ythuang96/FoamCutter/README.md

# FoamCutter

Download and unzip 'User Package.zip' for manual and all required code and AutoCAD templates.
