ythuang96/FoamCutter/SWITCH.docx

EXIT SWITCH | PAUSE SWITCH | WIRE CONTROL
| Pause | Wire always heated
Long hold to exit program and turn off Pi
| Running | Wire controlled by program
