ythuang96/FoamCutter/Code/C/RPI GPIO.png

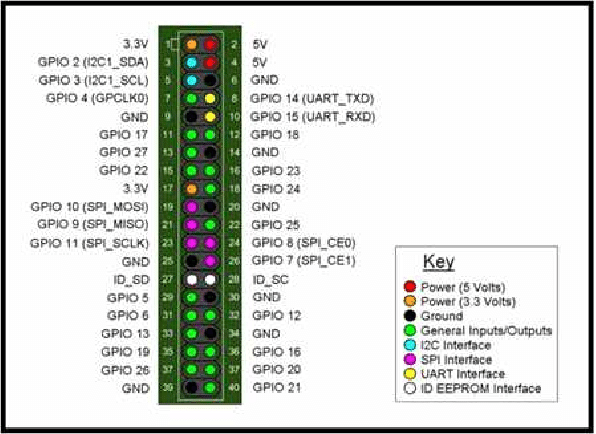
Code/C/RPI GPIO.png
