ythuang96/FoamCutter/Foamcutter V2.PNG

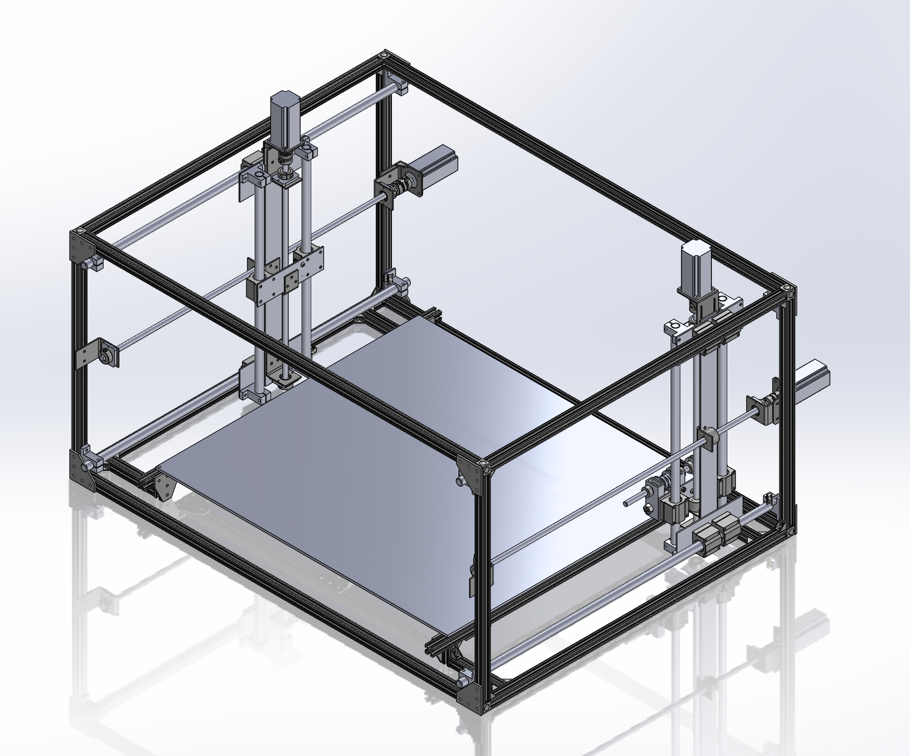
Foamcutter V2.PNG
