ythuang96/FoamCutter/Parts/Purchase_History.pdf

Category | Name | Spec | Unit Price | Amount for Final Desgin | | Amount Order1 | $1,235.68 | | Amount Order2 | $1,256.92 | | Amount Order3 | $148.63 | | Order4 Amount | $53.70
T-Slot | Rail | 1'' | 4ft | $12.31 | 4 | | 4 | $49.24 | | ---- | ---- | | ---- | ---- | | ---- | ----
| | | 3ft | $10.57 | 10 | | 9 | $95.13 | | 1 | $10.57 | | ---- | ---- | | ---- | ----
| | | 2ft | $7.79 | 5 | | 5 | $38.95 | | 1 | $7.79 | | ---- | ---- | | ---- | ----
| | | 1ft | $5.84 | 2 | | ---- | ---- | | ---- | ---- | | 2 | $11.68 | | ---- | ----
| Corner Brace | | | $4.96 | 38 | | 32 | $158.72 | | 6 | $29.76 | | ---- | ---- | | ---- | ----
| Corner Surface Bracket | | | $7.62 | 8 | | 8 | $60.96 | | 4 | $30.48 | | 8 | $60.96 | | ---- | ----
| Tee Surface Bracket | | | $7.95 | 10 | | 10 | $79.50 | | ---- | ---- | | ---- | ---- | | 2 | $15.90
| 3 Way Outside Corner | | | $9.86 | 8 | | 8 | $78.88 | | ---- | ---- | | ---- | ---- | | ---- | ----
| Fasten Plate | Single | | $2.30 | 10 | | 10 | $23.00 | | ---- | ---- | | ---- | ---- | | ---- | ----
| Fasten Plate | Dual | 1'' screw distance | $4.29 | 10 | | 10 | $42.90 | | ---- | ---- | | ---- | ---- | | ---- | ----
| Dust Cover | | | $4.15 | 3 | | 3 | $12.45 | | ---- | ---- | | ---- | ---- | | ---- | ----
Aluminum | L Bracket | 75 * 60 * 50 mm | $13.60 | 8 | 8 | $108.80 | ---- | ---- | ---- | ---- | ---- | ----
| L Bracket | 50 * 50 * 40 mm | $8.39 | 4 | 4 | $33.56 | ---- | ---- | ---- | ---- | ---- | ----
| Al Sheet | 2 * 24 * 1/8'' | $10.46 | 2 | 2 | $20.92 | ---- | ---- | ---- | ---- | ---- | ----
| Al Sheet | 8 * 8 * 1/8'' | $13.07 | 3 | 3 | $39.21 | ---- | ---- | ---- | ---- | ---- | ----
| Al Rod | 1 1/4'' OD 1'' length | $2.96 | 1 | ---- | ---- | ---- | ---- | 1 | $2.96 | ---- | ----
Electronics | Manual Switch | Toggle - Monentary | | $9.14 | 1 | 1 | $9.14 | ---- | ---- | ---- | ---- | ---- | ----
| | Toggle - Maintained | | $4.34 | 2 | 2 | $8.68 | ---- | ---- | ---- | ---- | ---- | ----
| Limit Switch | | | $7.17 | 4 | 4 | $28.68 | ---- | ---- | ---- | ---- | ---- | ----
| Standoff | | | $1.66 | 10 | 10 | $16.60 | ---- | ---- | ---- | ---- | ---- | ----
| Flat cable Signal | 26 awg | 4 cable | $2.08 | 10 | 10 | $20.80 | ---- | ---- | ---- | ---- | ---- | ----
| Flat cable Power | 18 awg | 4 cable | $3.78 | 10 | 10 | $37.80 | ---- | ---- | ---- | ---- | 10 | $37.80
Panel | Ruler | L to R | | $2.31 | 5 | 5 | $11.55 | ---- | ---- | ---- | ---- | ---- | ----
| | R to L | | $2.31 | 5 | 5 | $11.55 | ---- | ---- | ---- | ---- | ---- | ----
| Perforated Sheet | PVC 1/4'' thick | Hole D 0.25'' | $92.78 | 1 | 1 | $92.78 | ---- | ---- | ---- | ---- | ---- | ----
Wire Retractor | Constant-Force Spring | 10.60 lbs | Width 1'' | $10.83 | 1 | 1 | $10.83 | ---- | ---- | ---- | ---- | ---- | ----
| Sleeve Bearing | | Length 1/2'' | $0.67 | 1 | 1 | $0.67 | ---- | ---- | ---- | ---- | ---- | ----
| Sleeve Bearing | | Length 1 1/2'' | $4.71 | 1 | 1 | $4.71 | ---- | ---- | ---- | ---- | ---- | ----
| Sleeve Bearing | | Length 3/8'' | $1.50 | 0 | 2 | $3.00 | ---- | ---- | ---- | ---- | ---- | ----
| Flanged Sleeve Bearing | | Length 1'' | $2.28 | 2 | 2 | $4.56 | ---- | ---- | ---- | ---- | ---- | ----
| One-way Bearing | | Length 1/2'' | $11.17 | 1 | 1 | $11.17 | ---- | ---- | ---- | ---- | ---- | ----
| Shaft | | Length 9'' | $19.40 | 1 | 1 | $19.40 | ---- | ---- | ---- | ---- | ---- | ----
| Shaft Collar | | | $2.77 | 4 | 4 | $11.08 | ---- | ---- | ---- | ---- | ---- | ----
| Rectangular Tube | | Length 12'' | $9.12 | 1 | 1 | $9.12 | ---- | ---- | ---- | ---- | ---- | ----

Category | Name | Spec | Unit Price | Amount for Final Desgin | | Amount Order1 | $1,235.68 | | Amount Order2 | $1,256.92 | | Amount Order3 | $148.63 | | Order4 Amount | $53.70
Screw | Button Head Screw | 2-56 1/4'' | | $5.97 | 1 | | 1 | $5.97 | | ---- | ---- | | ---- | ---- | | ---- | ----
| | 4-40 0.5'' | | $3.38 | 1 | | 1 | $3.38 | | ---- | ---- | | ---- | ---- | | ---- | ----
| | 4-40 1 3/8'' | | $5.19 | 1 | | 1 | $5.19 | | ---- | ---- | | ---- | ---- | | ---- | ----
| | 1/4-20 0.5'' | | $8.35 | 1 | | 1 | $8.35 | | ---- | ---- | | ---- | ---- | | ---- | ----
| | 1/4-20 1'' | | $6.72 | 1 | | 1 | $6.72 | | ---- | ---- | | ---- | ---- | | ---- | ----
| Socket Head Screw | 1/2-13 3.5'' | | $5.05 | 1 | | 1 | $5.05 | | ---- | ---- | | ---- | ---- | | ---- | ----
| | M6 12mm | | $7.44 | 1 | | 1 | $7.44 | | ---- | ---- | | ---- | ---- | | ---- | ----
| | M6 20mm | | $4.44 | 1 | | 1 | $4.44 | | ---- | ---- | | ---- | ---- | | ---- | ----
| | M6 30mm | | $9.41 | 0 | | 1 | $9.41 | | ---- | ---- | | ---- | ---- | | ---- | ----
| Thumb Screw | 1/4-20 1/2'' | | $2.65 | 24 | | ---- | ---- | | ---- | ---- | | 24 | $63.60 | | ---- | ----
Nut | 4-40 Nut | | | $2.91 | 1 | | 1 | $2.91 | | ---- | ---- | | ---- | ---- | | ---- | ----
| 1/4-20 Nut | | | $7.24 | 1 | | 1 | $7.24 | | ---- | ---- | | ---- | ---- | | ---- | ----
| 1/2-13 Nut | | | $6.51 | 1 | | 1 | $6.51 | | ---- | ---- | | ---- | ---- | | ---- | ----
| M6 Nut | | | $8.73 | 1 | | 1 | $8.73 | | ---- | ---- | | ---- | ---- | | ---- | ----
Shaft | Shaft | 20mm | 1000mm | $95.82 | 4 | ---- | ---- | 2 | $191.64 | ---- | ---- | ---- | ----
| | 20mm | 600mm | $57.48 | 4 | ---- | ---- | 0 | $0.00 | ---- | ---- | ---- | ----
| Shaft Support | | | $25.19 | 16 | ---- | ---- | 8 | $201.52 | ---- | ---- | ---- | ----
Transmission | Linear Bearings | | | $68.20 | 12 | ---- | ---- | 4 | $272.80 | ---- | ---- | ---- | ----
| Shaft Coupler | 10mm to 1/2 inch | | $68.64 | 4 | ---- | ---- | 0 | $0.00 | ---- | ---- | ---- | ----
| Lead screw | 1/2''-10 | 3 ft | $36.59 | 4 | ---- | ---- | 4 | $146.36 | ---- | ---- | ---- | ----
| Nut | | OD 1.47'' | $36.81 | 4 | ---- | ---- | 4 | $147.24 | ---- | ---- | ---- | ----
| Collar | | OD 1.3125'' | $18.35 | 8 | ---- | ---- | 4 | $73.40 | ---- | ---- | ---- | ----
| Bearing | | OD 1.125'' | $9.08 | 0 | ---- | ---- | 8 | $72.64 | ---- | ---- | ---- | ----
| Shim | | | $11.59 | 1 | ---- | ---- | 1 | $11.59 | ---- | ---- | ---- | ----
Acrylic | 24'' * 48'' *1/4'' | $55.76 | 1 | ---- | ---- | 1 | $55.76 | ---- | ---- | ---- | ----
Acrylic | 6'' * 12'' * 1/8'' | $5.37 | 1 | ---- | ---- | 1 | $5.37 | ---- | ---- | ---- | ----
Delrin | 6'' * 6'' * 1/4'' | $9.43 | 1 | ---- | ---- | ---- | ---- | 1 | $9.43 | ---- | ----
