ythuang96/FoamCutter/Parts/ps_4__80714.1506972392.jpg

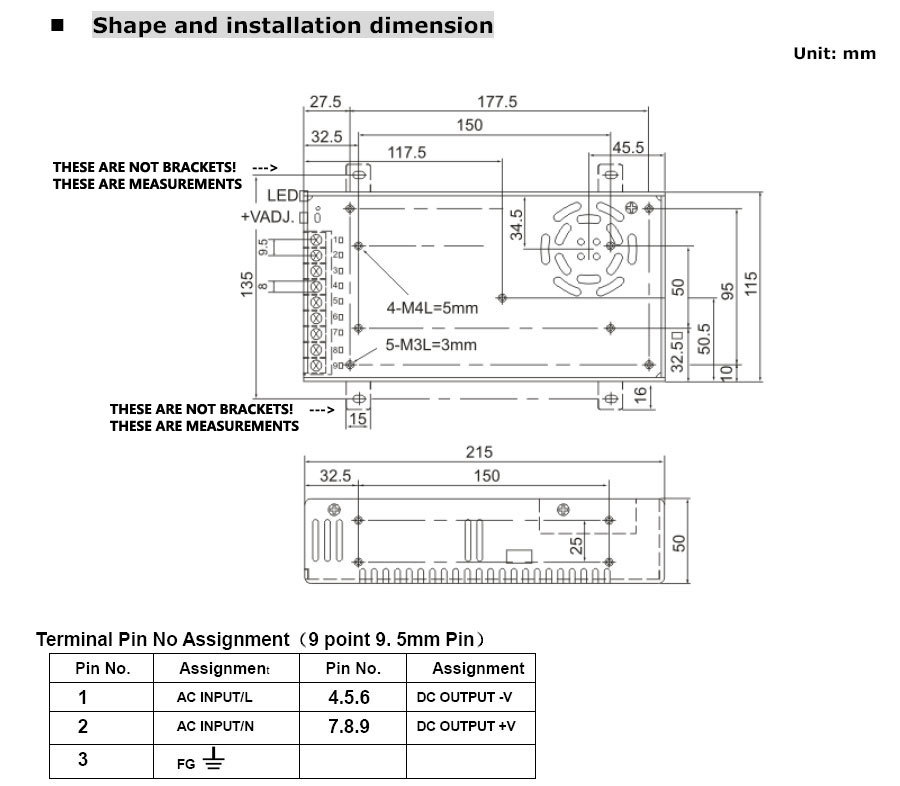
Parts/ps_4__80714.1506972392.jpg
