ythuang96/FoamCutter/Solidworks Files/Assembly/Frame/Electronics Box.SLDASM

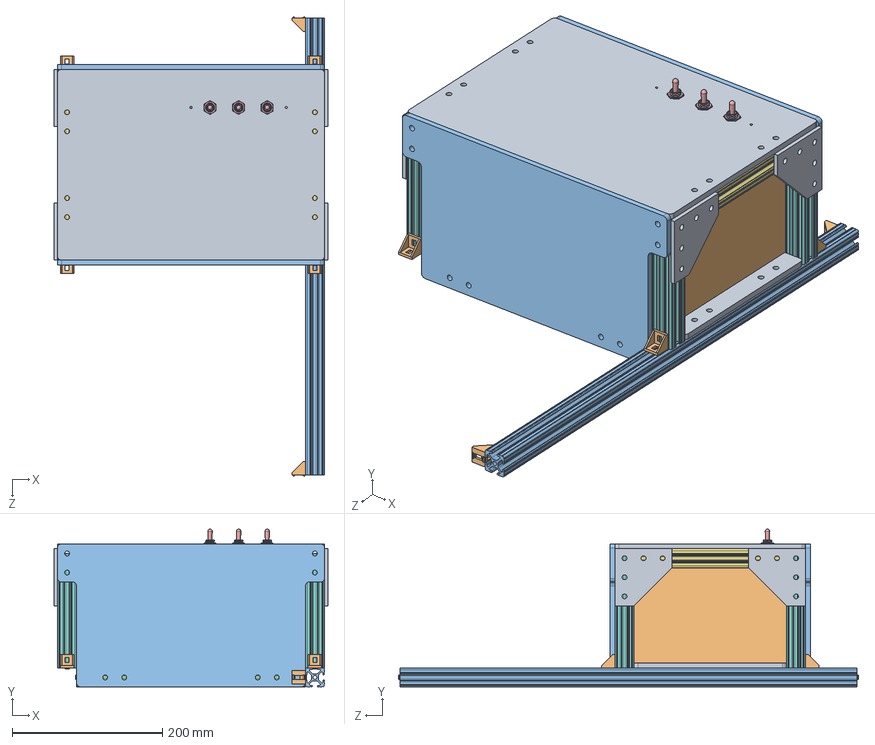
[picture p4: CAD file, 2018-08-23]
Solidworks Files/Assembly/Frame/Electronics Box.SLDASM
365.1 x 210.3 x 613.2 mm
Box Bottom x 2
Box Left x 2
Box Front x 2
Motor Drive x 4
PSU
pi
8 in x 2
6 in x 4
Corner Surface x 4
Corner Brace x 10
2 ft
1 ft x 2
Switch x 3
Switch Holder
