ythuang96/FoamCutter/Solidworks Files/Assembly/Horizontal Rail.SLDASM

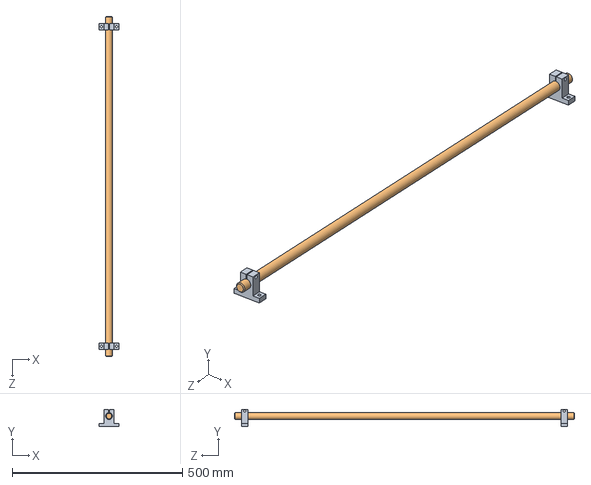
[picture p5: CAD file, 2018-08-23]
Solidworks Files/Assembly/Horizontal Rail.SLDASM
60.0 x 51.0 x 1000.0 mm
Shaft Clamp 20mm x 2
Shaft 1000mm
