ythuang96/FoamCutter/Solidworks Files/Assembly/Frame/Frame.SLDASM

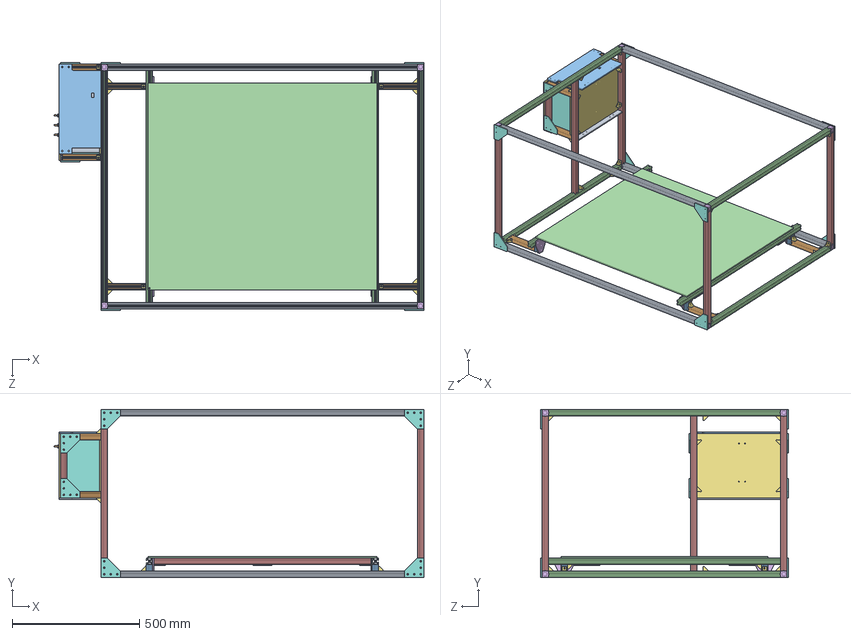
[picture p6: CAD file, 2018-08-23]
Solidworks Files/Assembly/Frame/Frame.SLDASM
1455.4 x 661.5 x 974.7 mm
3 ft x 6
2 ft x 6
Outside Corner x 8
Corner Brace x 42
Corner Surface x 12
4 ft x 4
6 in x 8
2 in x 4
PVC Panel
34in x 2
Surface T x 10
Box Bottom x 2
Box Left x 2
Box Front x 2
Motor Drive x 4
PSU
pi
8 in x 2
Switch x 3
Switch Holder
