ythuang96/FoamCutter/Solidworks Files/Assembly/Horizontal Motor.SLDASM

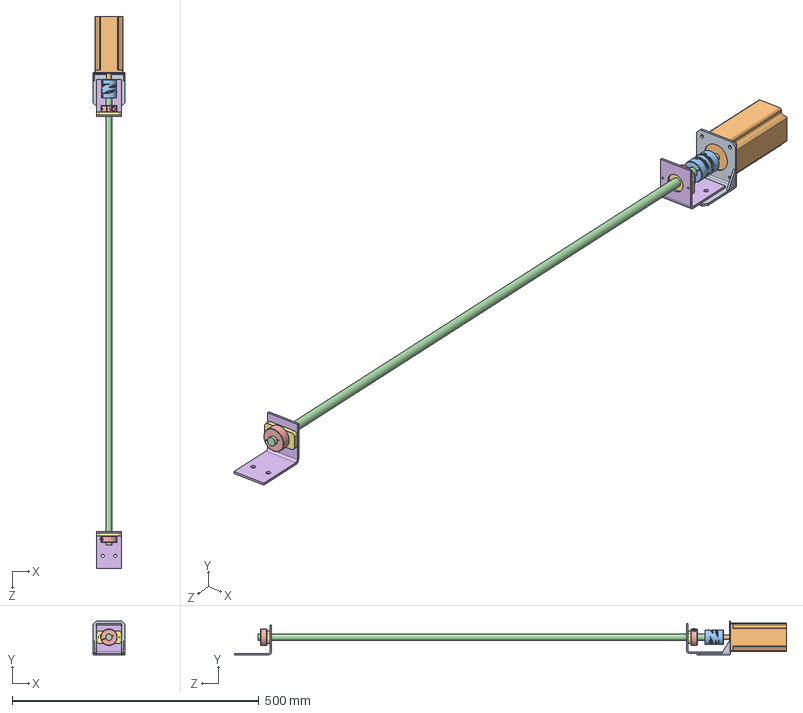
[picture p7: CAD file, 2018-08-23]
Solidworks Files/Assembly/Horizontal Motor.SLDASM
65.0 x 68.0 x 1118.5 mm
Motor Mount
Nema 23 Stepper Motor
Shaft Coupler
Lead Screw 3ft
Collar x 2
L Bracket x 2
Acrylic Bearing Mount x 2
