ythuang96/FoamCutter/Solidworks Files/Wire Retraction/Spring Pulley 2.SLDASM

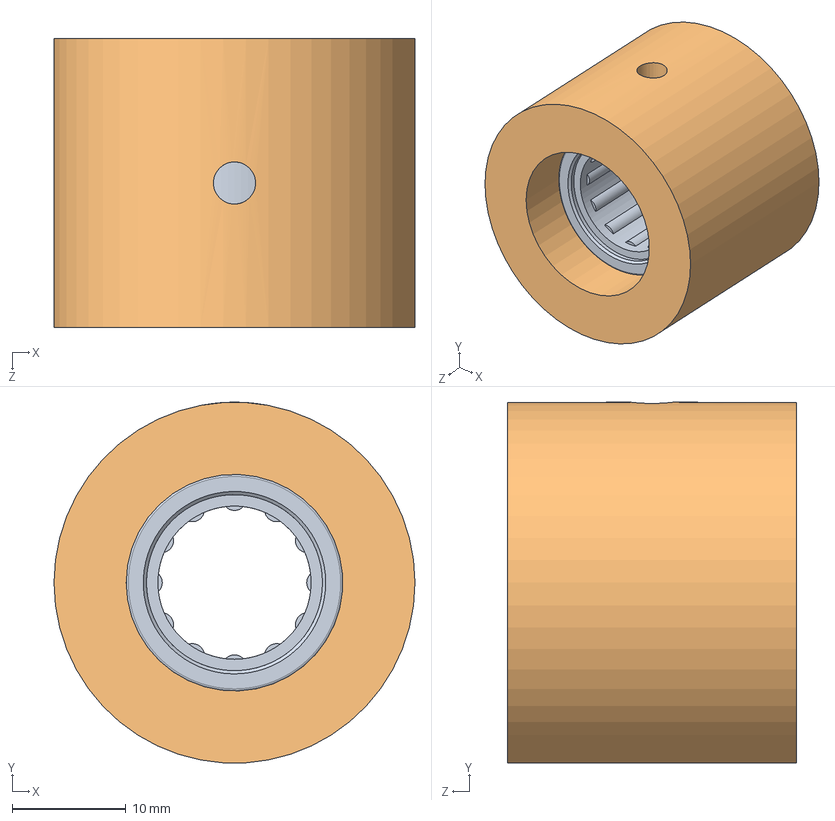
[picture p8: CAD file, 2018-08-23]
Solidworks Files/Wire Retraction/Spring Pulley 2.SLDASM
31.8 x 31.7 x 25.4 mm
One-Way Bearing
Al Pulley
