ythuang96/FoamCutter/Solidworks Files/Assembly/Frame/Box Side Frame.SLDASM

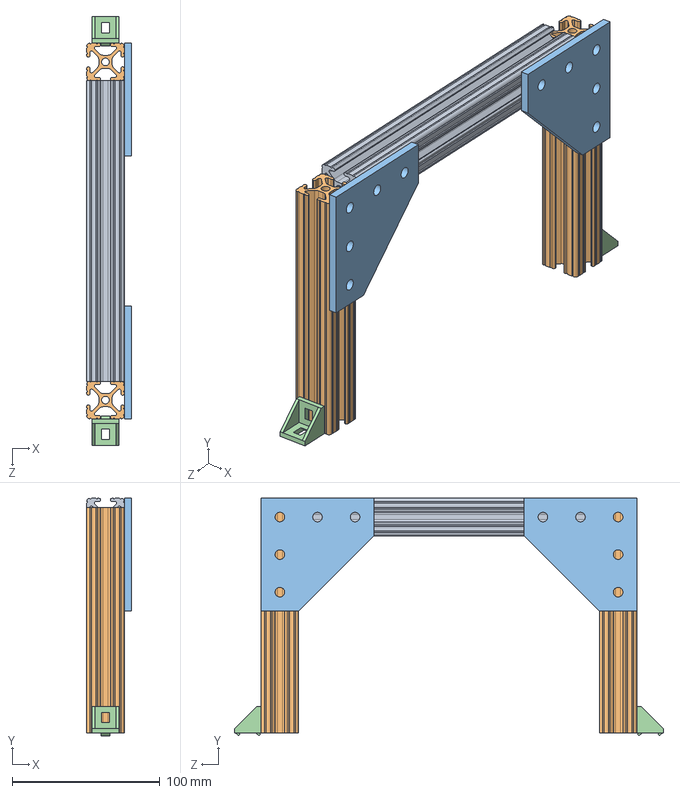
[picture p9: CAD file, 2018-08-23]
Solidworks Files/Assembly/Frame/Box Side Frame.SLDASM
30.2 x 160.6 x 290.0 mm
8 in
6 in x 2
Corner Surface x 2
Corner Brace x 2
