ythuang96/FoamCutter/Solidworks Files/Assembly/Vertical Motor.SLDASM

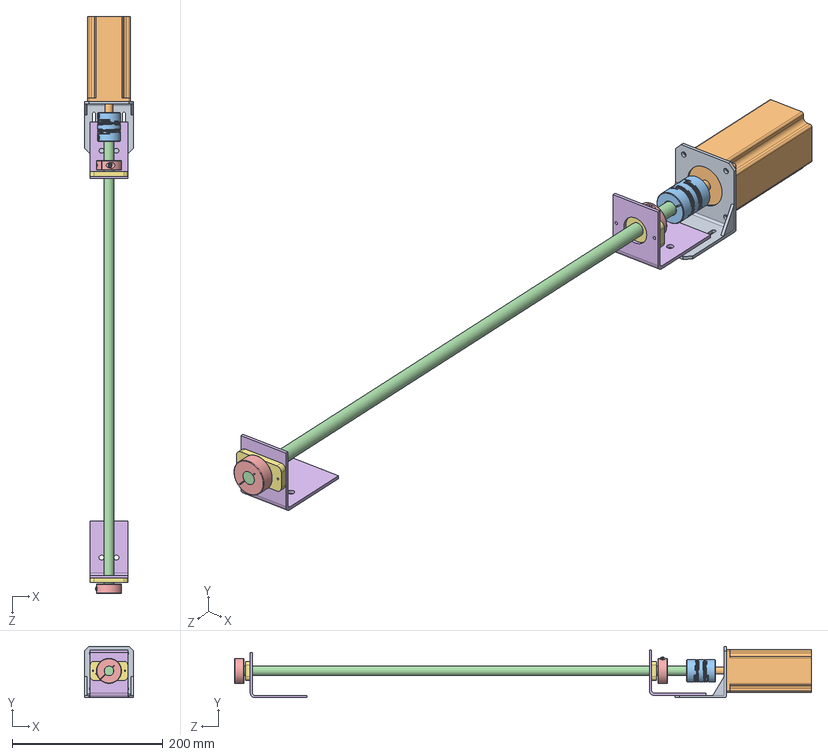
[picture p10: CAD file, 2018-08-23]
Solidworks Files/Assembly/Vertical Motor.SLDASM
65.0 x 68.0 x 765.8 mm
Motor Mount
Nema 23 Stepper Motor
Shaft Coupler
Lead Screw 2.5ft
Collar x 2
L Bracket x 2
Acrylic Bearing Mount x 2
