ythuang96/FoamCutter/Solidworks Files/Assembly/Frame/Side Frame.SLDASM

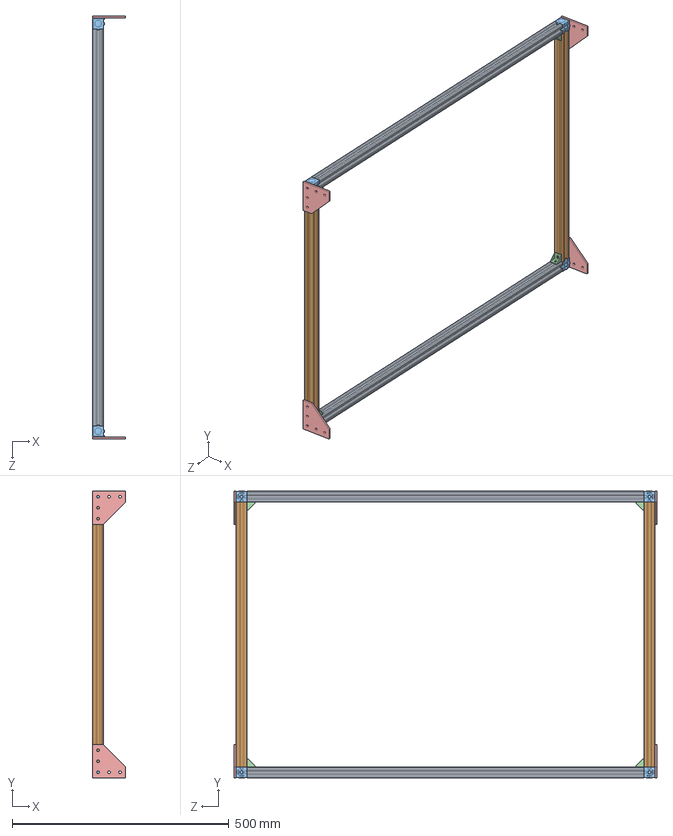
[picture p11: CAD file, 2018-08-23]
Solidworks Files/Assembly/Frame/Side Frame.SLDASM
76.7 x 661.5 x 974.7 mm
3 ft x 2
2 ft x 2
Outside Corner x 4
Corner Brace x 4
Corner Surface x 4
