ythuang96/FoamCutter/Solidworks Files/Assembly/Limit Swtich Assembly 2.SLDASM

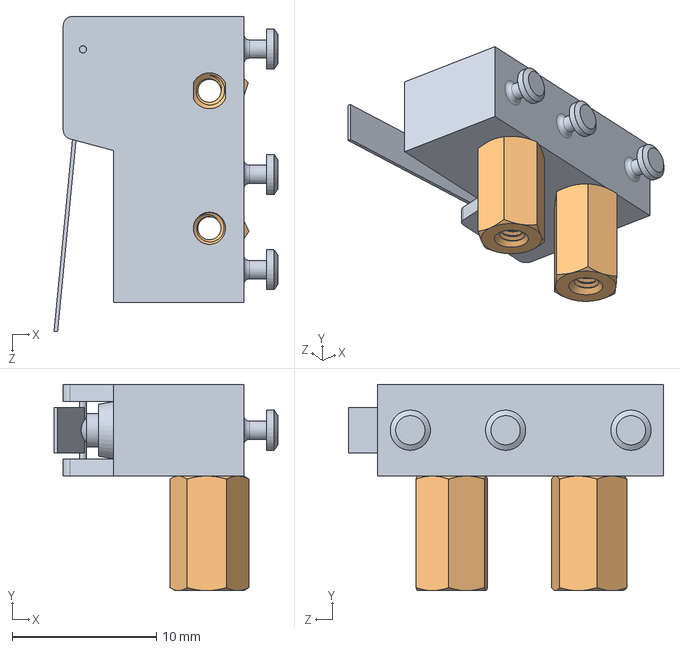
[picture p12: CAD file, 2018-08-23]
Solidworks Files/Assembly/Limit Swtich Assembly 2.SLDASM
15.5 x 14.3 x 21.8 mm
Limit Switch
Standoff x 2
