ythuang96/FoamCutter/Solidworks Files/Assembly/Vertical Left.SLDASM

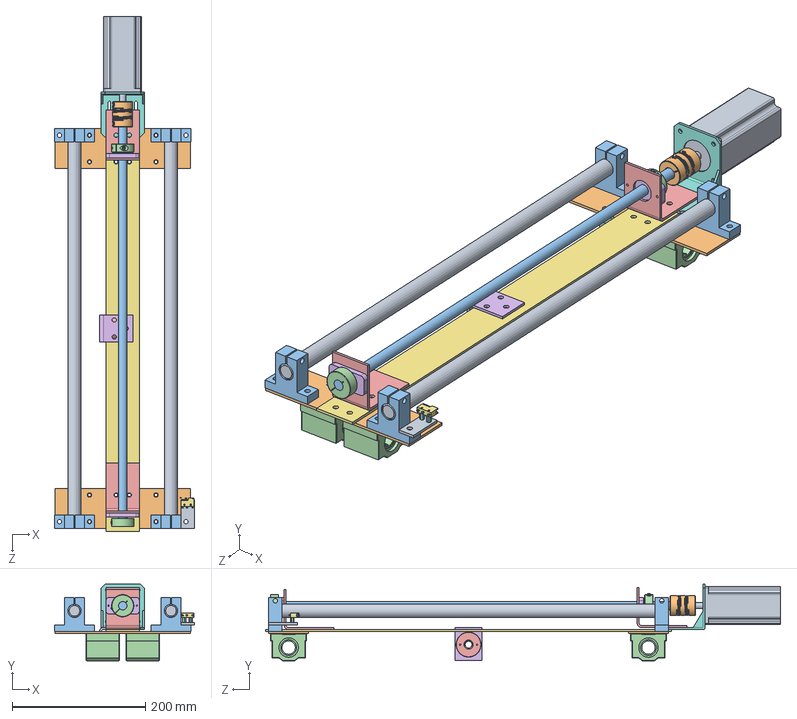
[picture p13: CAD file, 2018-08-23]
Solidworks Files/Assembly/Vertical Left.SLDASM
210.1 x 115.3 x 773.0 mm
Shaft 600mm x 2
Al sheet 1 x 2
Shaft Clamp 20mm x 4
20mm Linear Bearing x 4
Nut
L Bracket -- Nut Horizontal
Al sheet 2
Motor Mount
Nema 23 Stepper Motor
Shaft Coupler
Lead Screw 2.5ft
Collar x 2
L Bracket x 2
Acrylic Bearing Mount x 2
Limit Switch
Standoff x 2
Al sheet 4-2
