ythuang96/FoamCutter/Solidworks Files/Wire Retraction/Wire Pulley.SLDASM

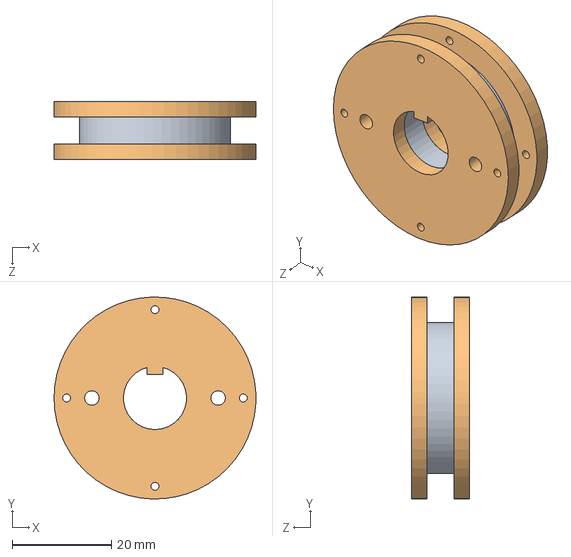
[picture p14: CAD file, 2018-08-23]
Solidworks Files/Wire Retraction/Wire Pulley.SLDASM
40.6 x 40.6 x 11.7 mm
Wire Pully Inside
Flange x 2
