ythuang96/FoamCutter/Solidworks Files/Assembly/Wire Holder Left.SLDASM

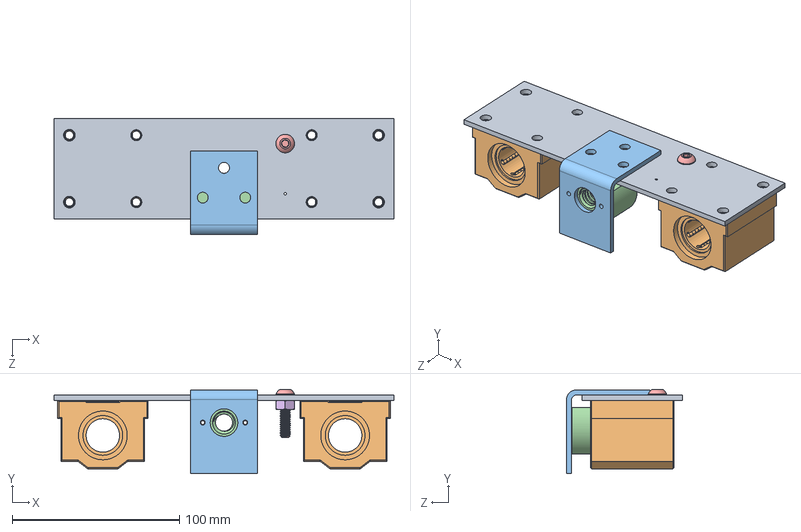
[picture p15: CAD file, 2018-08-23]
Solidworks Files/Assembly/Wire Holder Left.SLDASM
203.2 x 50.4 x 69.4 mm
Al sheet 3-1
20mm Linear Bearing x 2
L Bracket -- Nut Vertical
Nut
0.25 Nut
