ythuang96/FoamCutter/Solidworks Files/Assembly/Vertical Slider.SLDASM

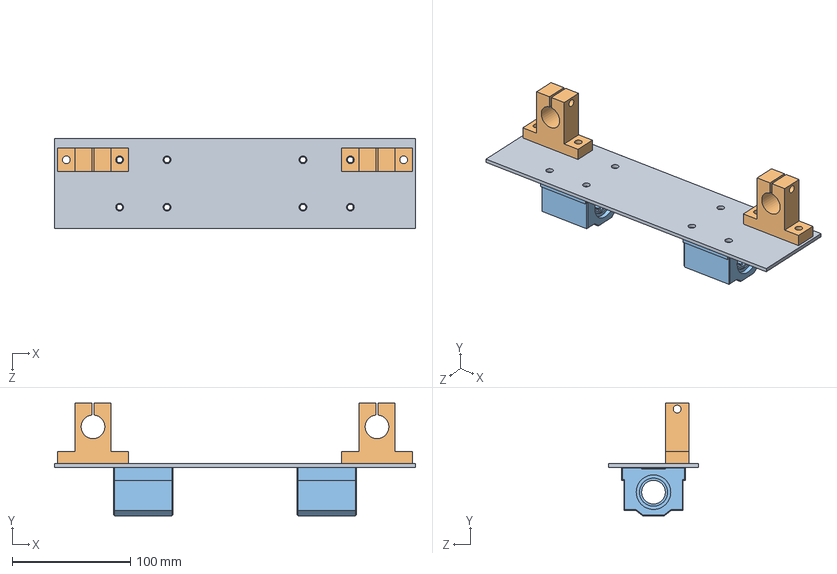
[picture p16: CAD file, 2018-08-23]
Solidworks Files/Assembly/Vertical Slider.SLDASM
304.8 x 95.2 x 76.2 mm
Al sheet 1
Shaft Clamp 20mm x 2
20mm Linear Bearing x 2
