ythuang96/FoamCutter/Solidworks Files/Wire Retraction/Spring Assembly.SLDASM

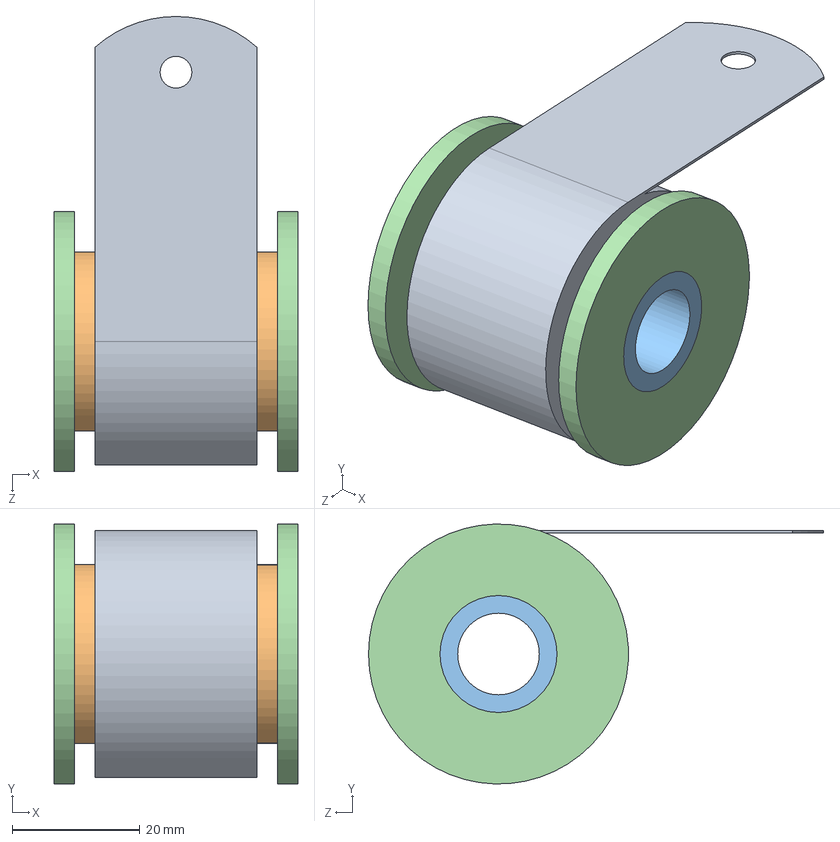
[picture p17: CAD file, 2018-08-23]
Solidworks Files/Wire Retraction/Spring Assembly.SLDASM
38.1 x 40.6 x 71.1 mm
Constant Force Spring
Spring Pully Inside x 5
Sleeve Bearing 1.5
Flange x 2
