ythuang96/FoamCutter/Solidworks Files/Wire Retraction/Retractor Assembly.SLDASM

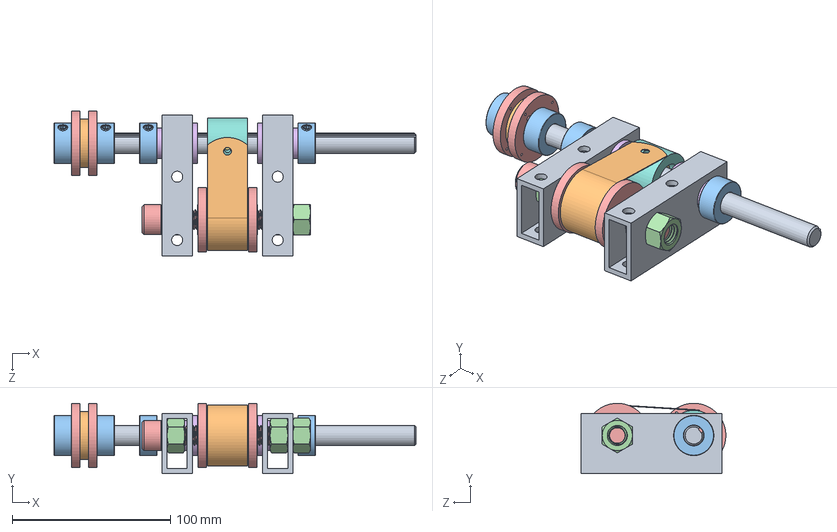
[picture p18: CAD file, 2018-08-23]
Solidworks Files/Wire Retraction/Retractor Assembly.SLDASM
228.6 x 44.4 x 91.4 mm
Rectangle Tube x 2
Constant Force Spring
Spring Pully Inside x 5
Sleeve Bearing 1.5
Flange x 4
Flanged Sleeve Bearing 1 x 2
One-Way Bearing
Al Pulley
Shaft
Wire Pully Inside
Shaft Collar x 4
0.5 Nut x 3
