ythuang96/FoamCutter/Solidworks Files/Al/Al sheet 2.SLDPRT

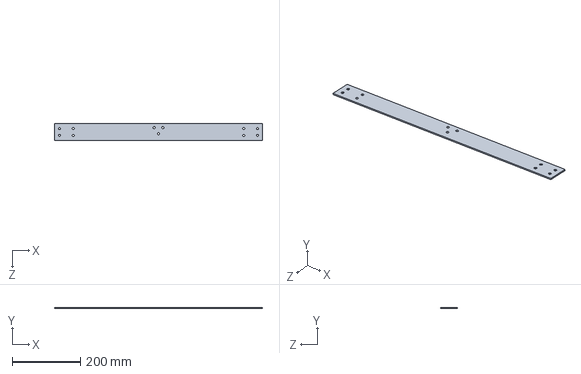
[picture p19: CAD file, 2018-08-23]
Solidworks Files/Al/Al sheet 2.SLDPRT
609.6 x 3.17 x 50.8 mm
