ythuang96/FoamCutter/Solidworks Files/Electronics Box/Box Front.SLDPRT

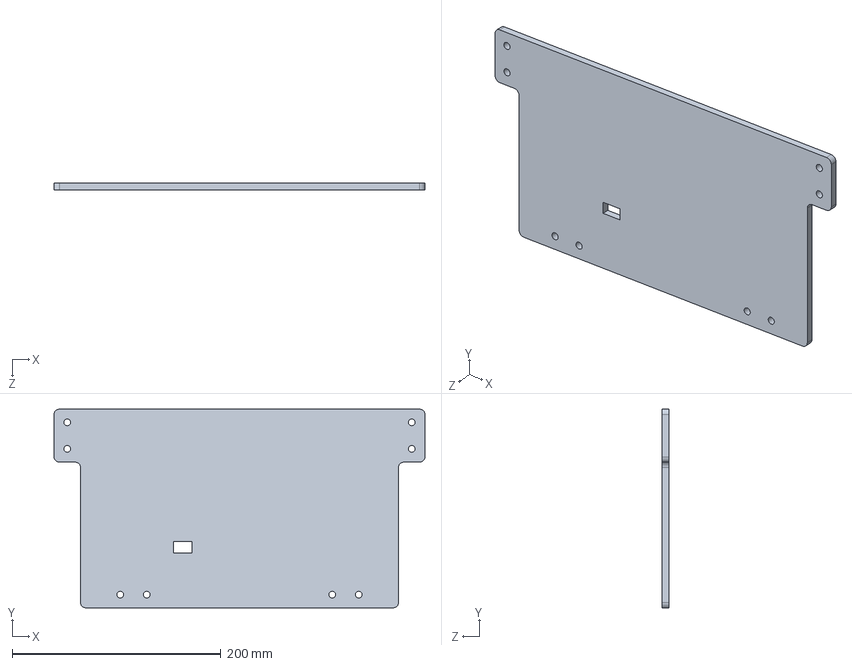
[picture p20: CAD file, 2018-08-23]
Solidworks Files/Electronics Box/Box Front.SLDPRT
355.6 x 190.5 x 6.35 mm
