ythuang96/FoamCutter/Solidworks Files/Electronics/Standoff.SLDPRT

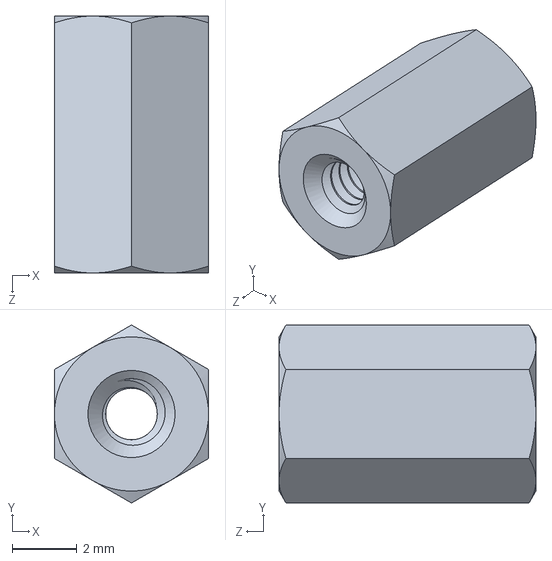
[picture p21: CAD file, 2018-08-23]
Solidworks Files/Electronics/Standoff.SLDPRT
4.76 x 5.50 x 7.94 mm
