ythuang96/FoamCutter/Solidworks Files/Laser/Box/Bottom.DXF

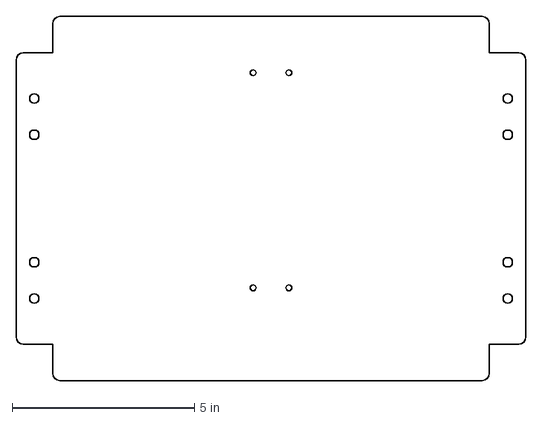
[picture p22: CAD file, 2018-08-23]
Solidworks Files/Laser/Box/Bottom.DXF
14.0 x 10.0 in
