ythuang96/FoamCutter/Solidworks Files/Laser/Guiding Block/Block Laser.dxf

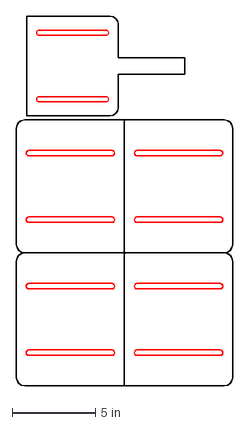
[picture p23: CAD file, 2018-08-23]
Solidworks Files/Laser/Guiding Block/Block Laser.dxf
13.0 x 22.2 in
