ythuang96/FoamCutter/Solidworks Files/Shaft 1000mm.SLDPRT

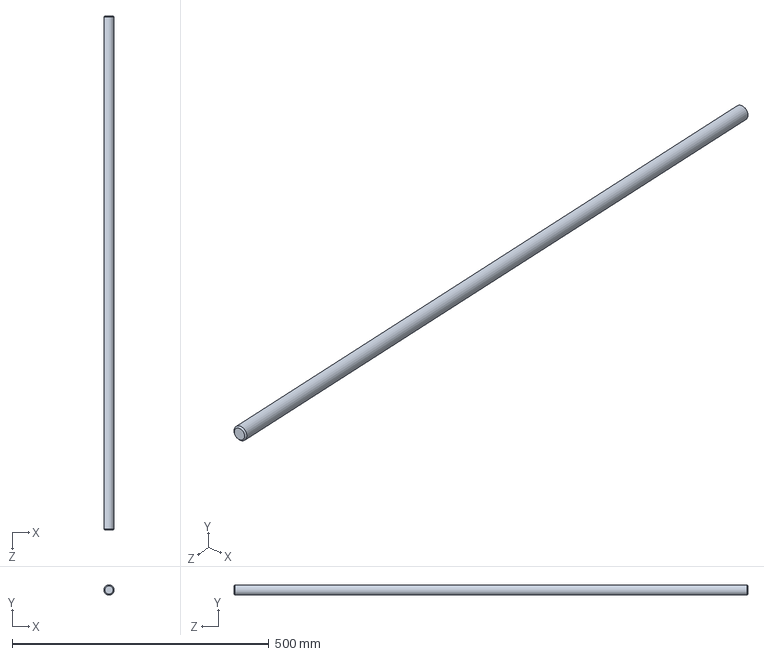
[picture p24: CAD file, 2018-08-23]
Solidworks Files/Shaft 1000mm.SLDPRT
20.0 x 20.0 x 1000.0 mm
