ythuang96/FoamCutter/Solidworks Files/T-Slot/6 in.SLDPRT

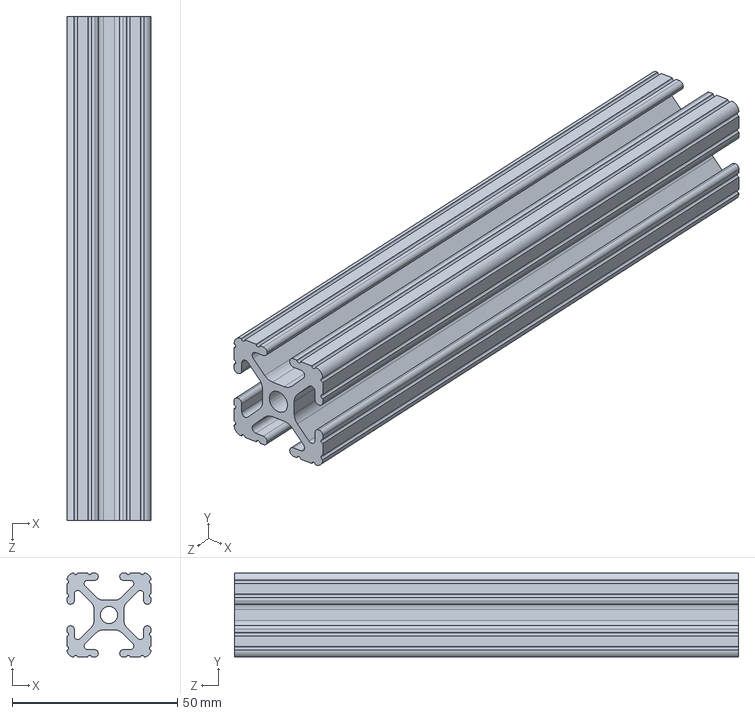
[picture p25: CAD file, 2018-08-23]
Solidworks Files/T-Slot/6 in.SLDPRT
25.4 x 25.4 x 152.4 mm
