ythuang96/FoamCutter/Solidworks Files/Wire Retraction/Acrylic/Spring Pully Inside.SLDPRT

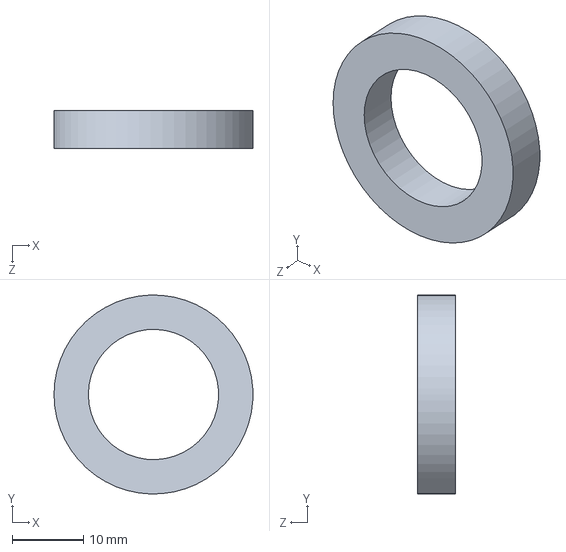
[picture p26: CAD file, 2018-08-23]
Solidworks Files/Wire Retraction/Acrylic/Spring Pully Inside.SLDPRT
27.9 x 27.9 x 5.33 mm
