ythuang96/FoamCutter/Solidworks Files/Wire Retraction/Shaft.SLDPRT

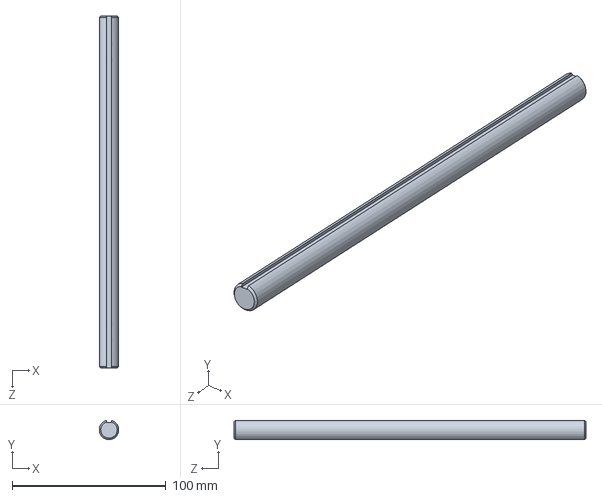
[picture p27: CAD file, 2018-08-23]
Solidworks Files/Wire Retraction/Shaft.SLDPRT
12.7 x 12.4 x 228.6 mm
