ythuang96/FoamCutter/Solidworks Files/Work Bench/PVC Panel.SLDPRT

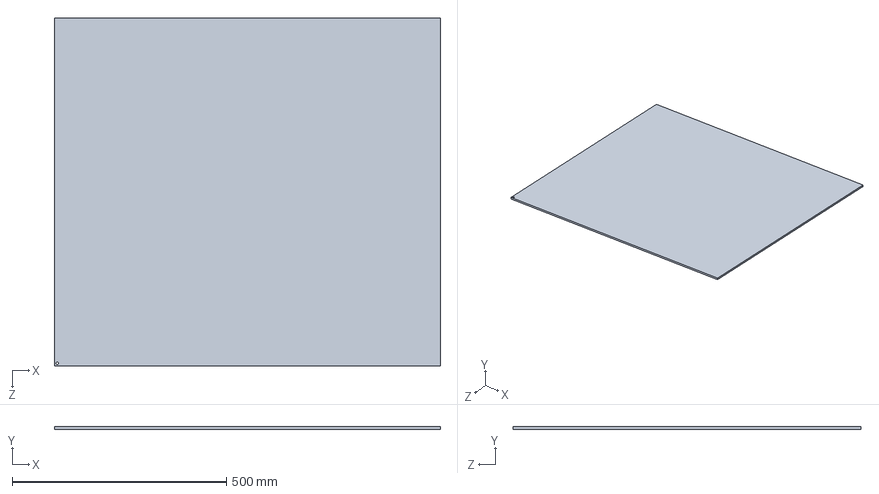
[picture p28: CAD file, 2018-08-23]
Solidworks Files/Work Bench/PVC Panel.SLDPRT
901.7 x 6.35 x 812.8 mm
