ythuang96/FoamCutter/Solidworks Files/Al/L Bracket.SLDPRT

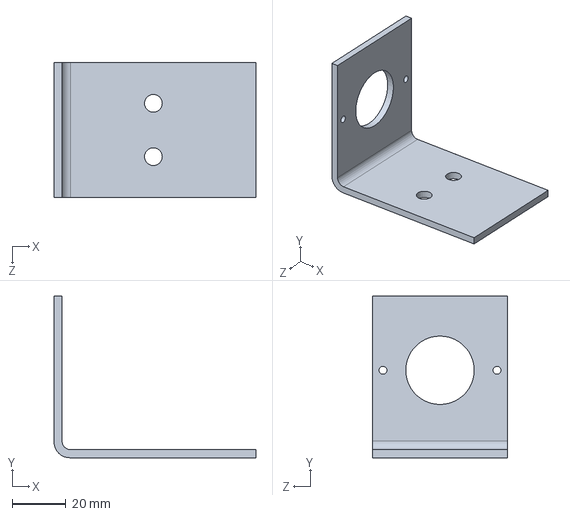
[picture p29: CAD file, 2018-08-23]
Solidworks Files/Al/L Bracket.SLDPRT
75.0 x 60.0 x 50.0 mm
