ythuang96/FoamCutter/Solidworks Files/Electronics Box/Box Left.SLDPRT

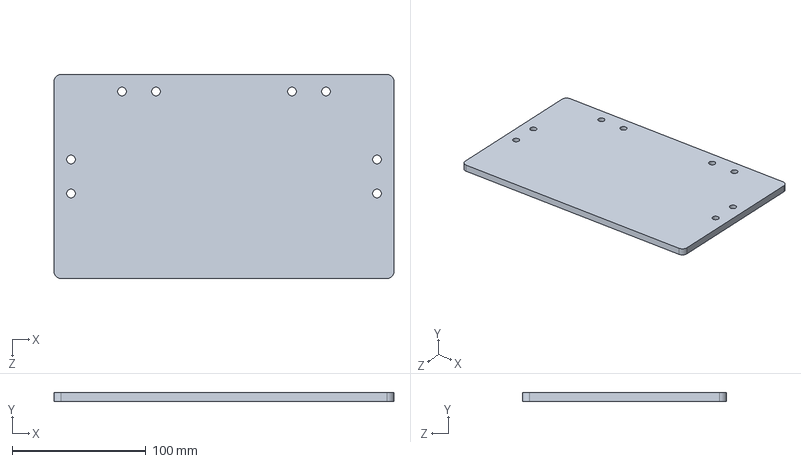
[picture p30: CAD file, 2018-08-23]
Solidworks Files/Electronics Box/Box Left.SLDPRT
254.0 x 6.35 x 152.4 mm
