ythuang96/FoamCutter/Solidworks Files/Electronics/Switch Holder.SLDPRT

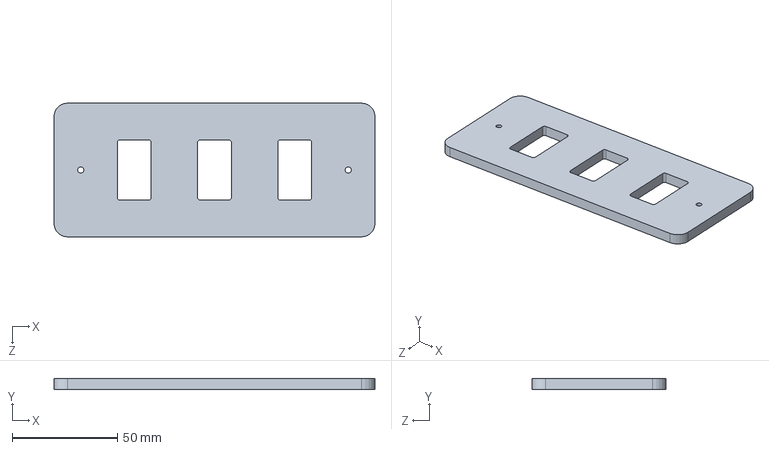
[picture p31: CAD file, 2018-08-23]
Solidworks Files/Electronics/Switch Holder.SLDPRT
152.4 x 5.33 x 63.5 mm
