ythuang96/FoamCutter/Solidworks Files/Laser/Box/Top.DXF

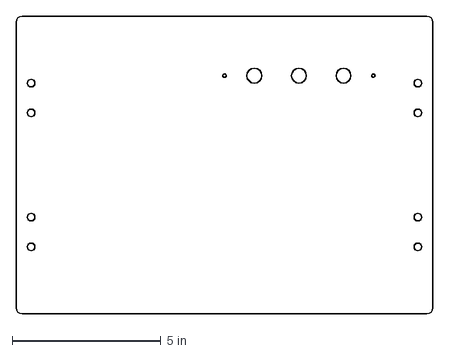
[picture p32: CAD file, 2018-08-23]
Solidworks Files/Laser/Box/Top.DXF
14.0 x 10.0 in
