ythuang96/FoamCutter/Solidworks Files/Laser/Guiding Block/Guiding Block2.DXF

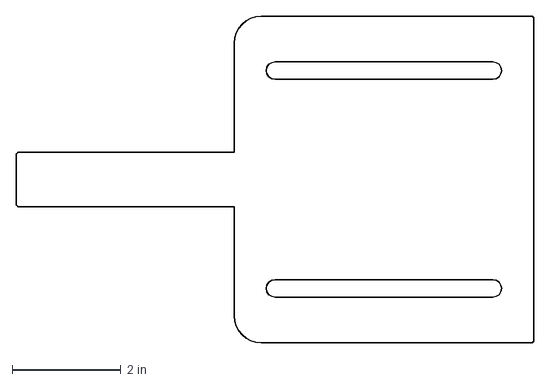
[picture p33: CAD file, 2018-08-23]
Solidworks Files/Laser/Guiding Block/Guiding Block2.DXF
9.50 x 6.00 in
