ythuang96/FoamCutter/Solidworks Files/Laser/Shaft Pulley.DXF

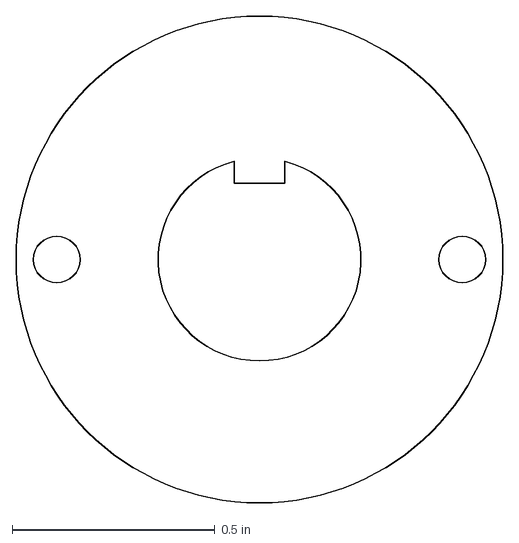
[picture p34: CAD file, 2018-08-23]
Solidworks Files/Laser/Shaft Pulley.DXF
1.20 x 1.20 in
