ythuang96/FoamCutter/Solidworks Files/Shaft 600mm.SLDPRT

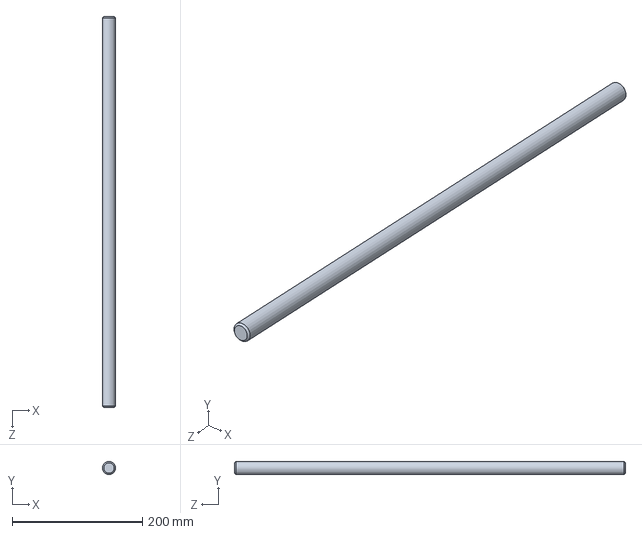
[picture p35: CAD file, 2018-08-23]
Solidworks Files/Shaft 600mm.SLDPRT
20.0 x 20.0 x 600.0 mm
