ythuang96/FoamCutter/Solidworks Files/T-Slot/Surface T.SLDPRT

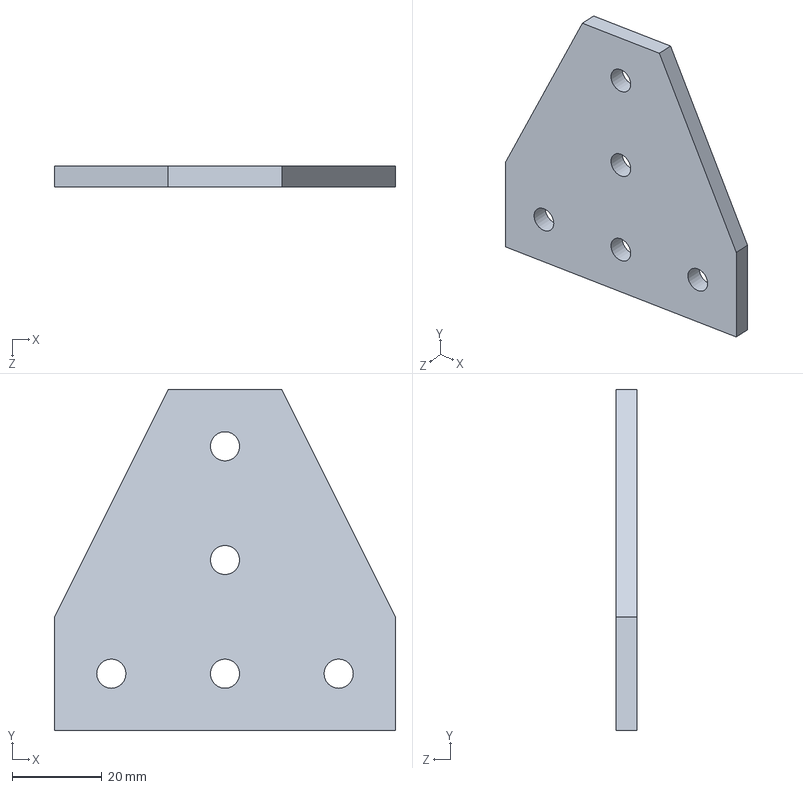
[picture p36: CAD file, 2018-08-23]
Solidworks Files/T-Slot/Surface T.SLDPRT
76.2 x 76.2 x 4.76 mm
