ythuang96/FoamCutter/Solidworks Files/Wire Retraction/Acrylic/Wire Pully Inside.SLDPRT

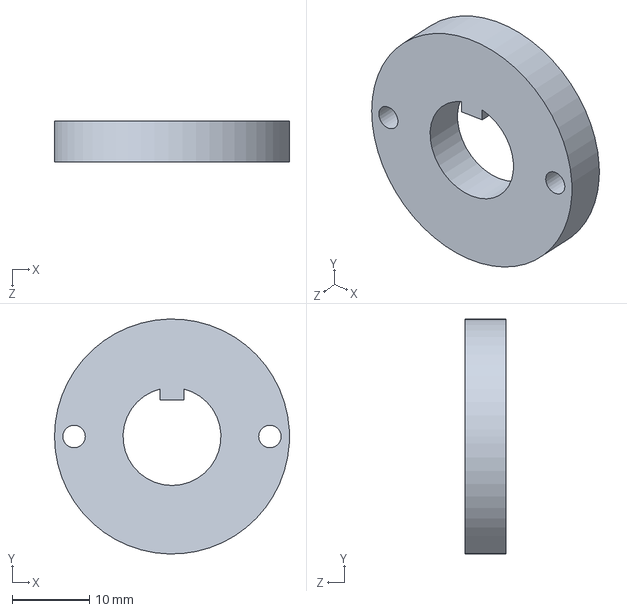
[picture p37: CAD file, 2018-08-23]
Solidworks Files/Wire Retraction/Acrylic/Wire Pully Inside.SLDPRT
30.5 x 30.5 x 5.33 mm
