ythuang96/FoamCutter/Solidworks Files/Work Bench/Guiding Block1.SLDPRT

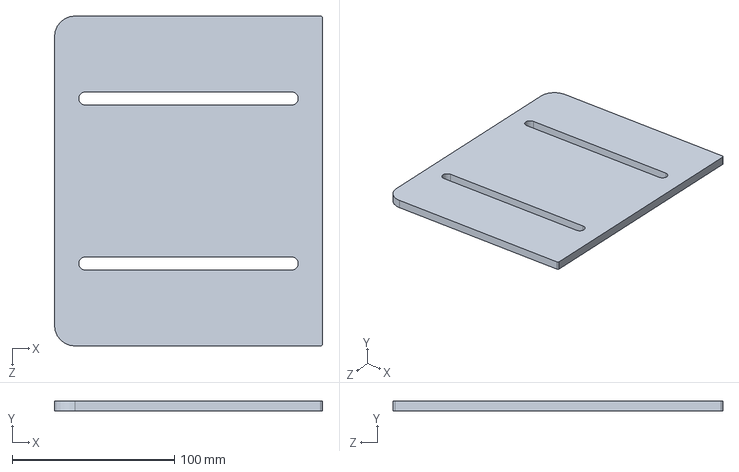
[picture p38: CAD file, 2018-08-23]
Solidworks Files/Work Bench/Guiding Block1.SLDPRT
165.1 x 6.35 x 203.2 mm
