ythuang96/FoamCutter/Solidworks Files/Al/Al sheet 3-1.SLDPRT

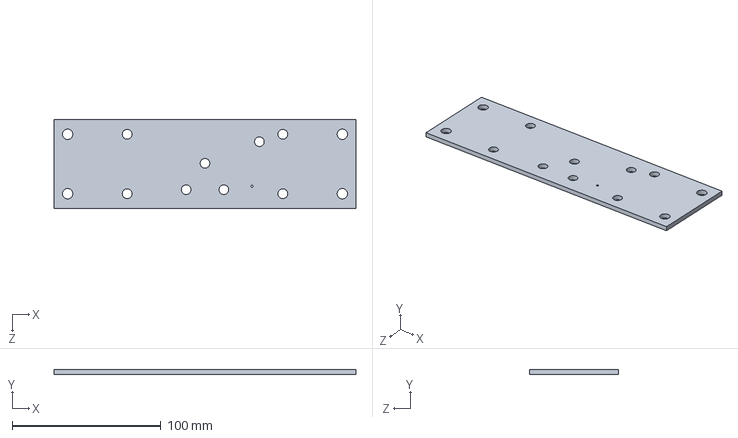
[picture p39: CAD file, 2018-08-23]
Solidworks Files/Al/Al sheet 3-1.SLDPRT
203.2 x 3.17 x 60.0 mm
