ythuang96/FoamCutter/Solidworks Files/Electronics Box/Box Bottom.SLDPRT

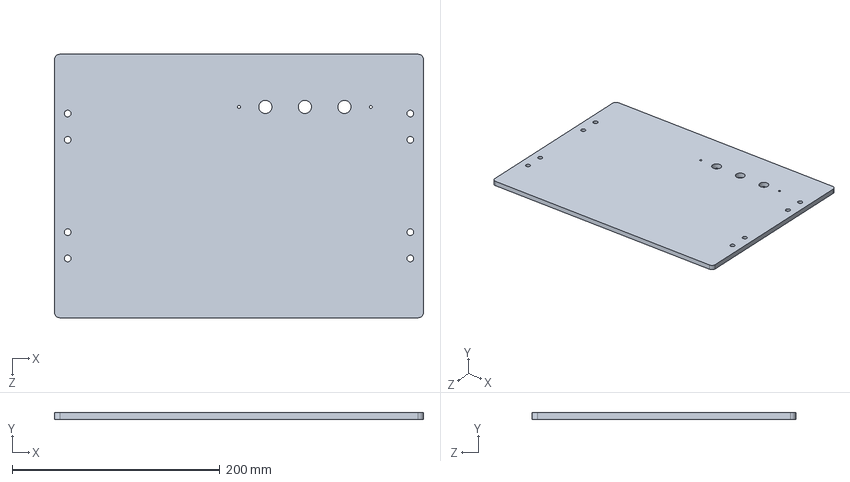
[picture p40: CAD file, 2018-08-23]
Solidworks Files/Electronics Box/Box Bottom.SLDPRT
355.6 x 6.35 x 254.0 mm
