ythuang96/FoamCutter/Solidworks Files/Electronics/Motor Drive.SLDPRT

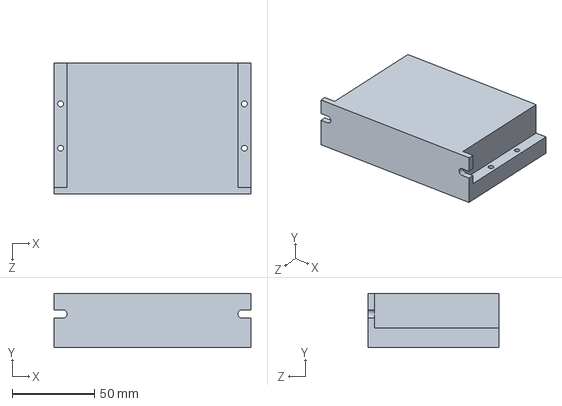
[picture p41: CAD file, 2018-08-23]
Solidworks Files/Electronics/Motor Drive.SLDPRT
120.0 x 33.0 x 80.0 mm
