ythuang96/FoamCutter/Solidworks Files/Laser/Acrylic Bearing Mount.DXF

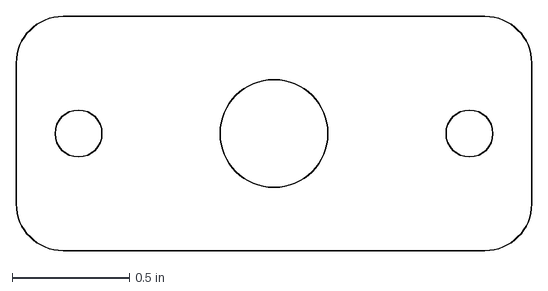
[picture p42: CAD file, 2018-08-23]
Solidworks Files/Laser/Acrylic Bearing Mount.DXF
2.20 x 1.00 in
