ythuang96/FoamCutter/Solidworks Files/Laser/Box/Left.DXF

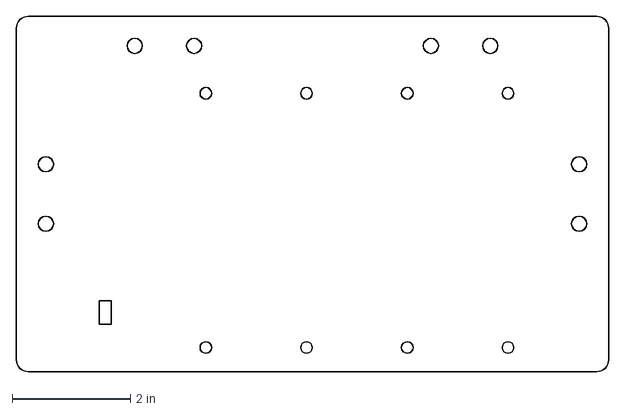
[picture p43: CAD file, 2018-08-23]
Solidworks Files/Laser/Box/Left.DXF
10.0 x 6.00 in
