ythuang96/FoamCutter/Solidworks Files/Laser/Guiding Block/Guiding Block1.DXF

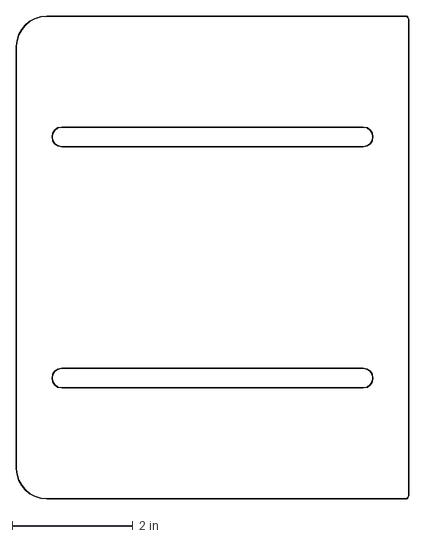
[picture p44: CAD file, 2018-08-23]
Solidworks Files/Laser/Guiding Block/Guiding Block1.DXF
6.50 x 8.00 in
