ythuang96/FoamCutter/Solidworks Files/Shaft Clamp 20mm.SLDPRT

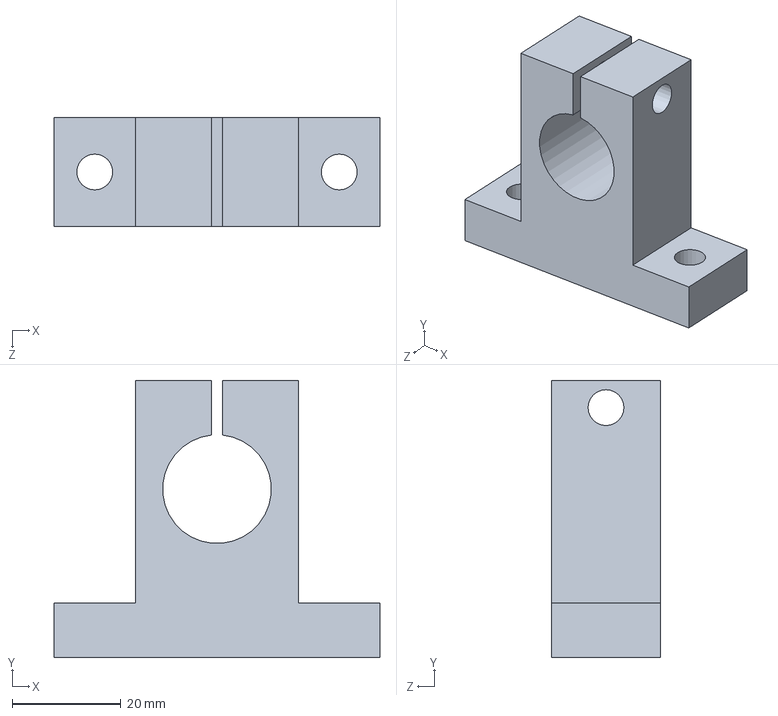
[picture p45: CAD file, 2018-08-23]
Solidworks Files/Shaft Clamp 20mm.SLDPRT
60.0 x 51.0 x 20.0 mm
