ythuang96/FoamCutter/Solidworks Files/T-Slot/2 in.SLDPRT

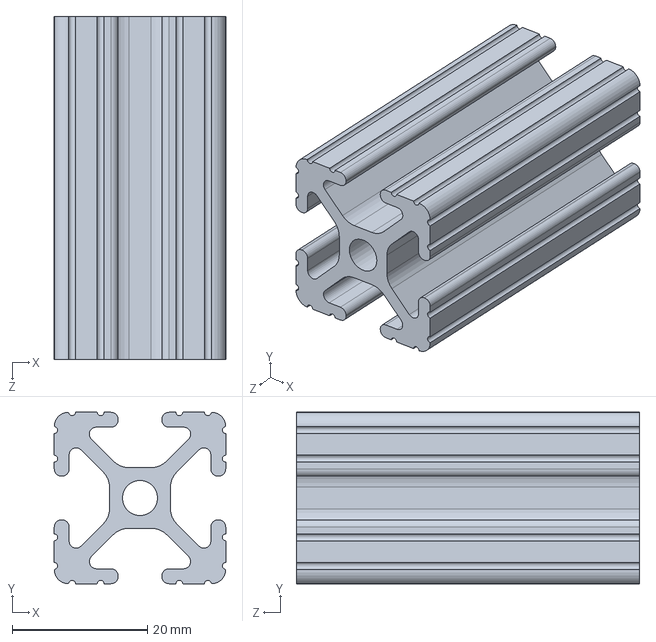
[picture p46: CAD file, 2018-08-23]
Solidworks Files/T-Slot/2 in.SLDPRT
25.4 x 25.4 x 50.8 mm
