ythuang96/FoamCutter/Solidworks Files/Wire Retraction/Acrylic/Flange.SLDPRT

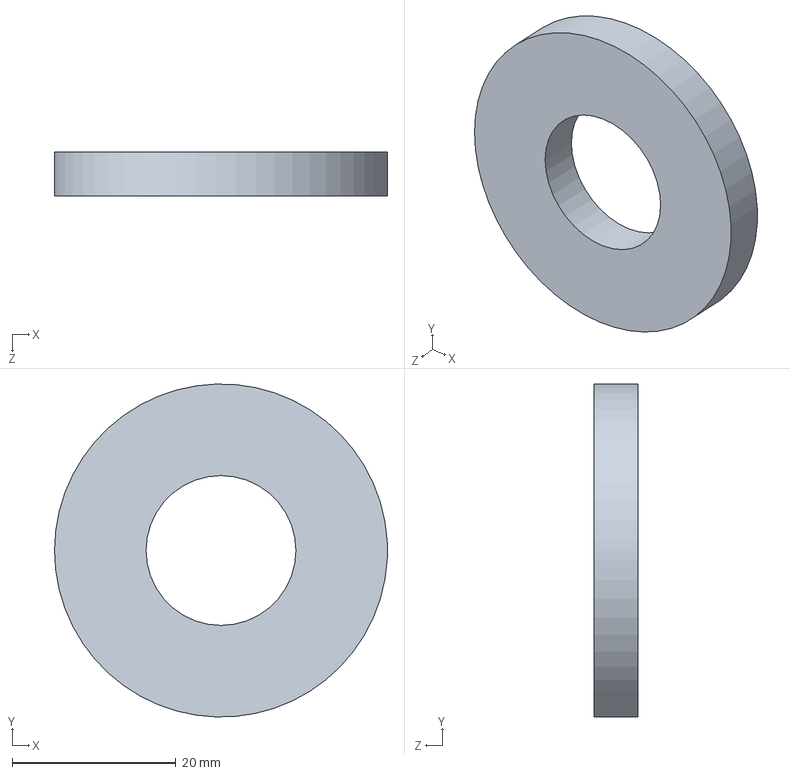
[picture p47: CAD file, 2018-08-23]
Solidworks Files/Wire Retraction/Acrylic/Flange.SLDPRT
40.6 x 40.6 x 5.33 mm
