ythuang96/FoamCutter/Solidworks Files/Wire Retraction/Sleeve Bearing 0.375.SLDPRT

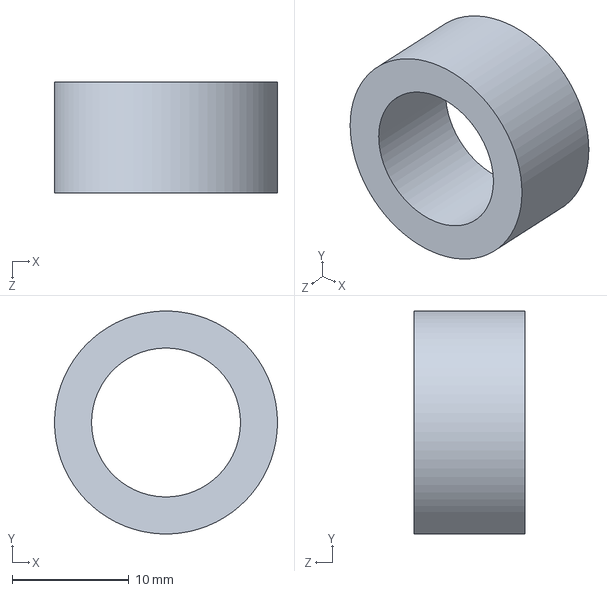
[picture p48: CAD file, 2018-08-23]
Solidworks Files/Wire Retraction/Sleeve Bearing 0.375.SLDPRT
19.1 x 19.1 x 9.53 mm
