ythuang96/FoamCutter/Solidworks Files/Work Bench/Guiding Block2.SLDPRT

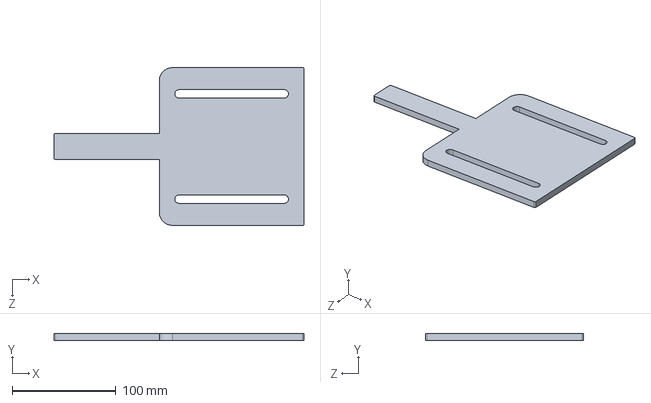
[picture p49: CAD file, 2018-08-23]
Solidworks Files/Work Bench/Guiding Block2.SLDPRT
241.3 x 6.35 x 152.4 mm
