ythuang96/FoamCutter/Solidworks Files/20mm Linear Bearing.SLDPRT

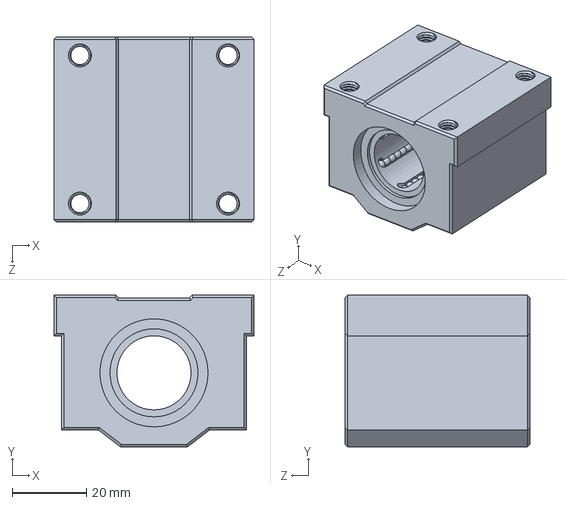
[picture p50: CAD file, 2018-08-23]
Solidworks Files/20mm Linear Bearing.SLDPRT
54.0 x 41.0 x 50.0 mm
