ythuang96/FoamCutter/Solidworks Files/Al/Rectangle Tube 2.SLDPRT

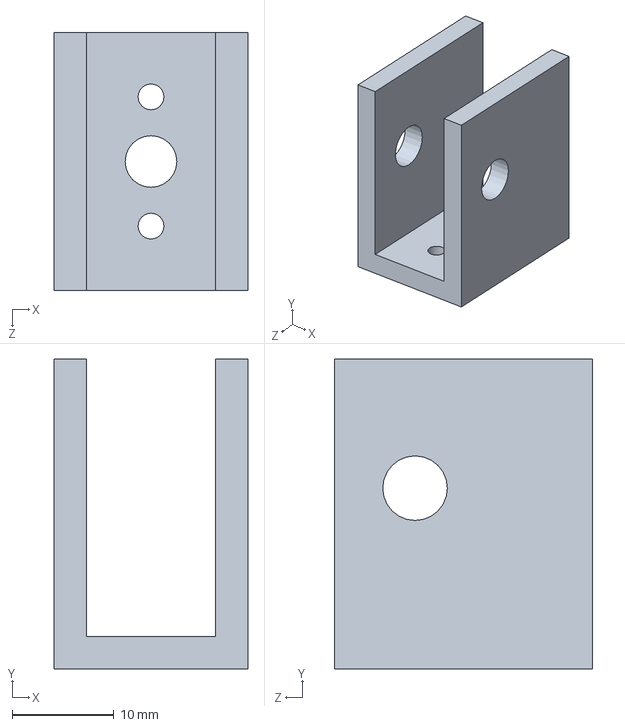
[picture p51: CAD file, 2018-08-23]
Solidworks Files/Al/Rectangle Tube 2.SLDPRT
19.1 x 30.5 x 25.4 mm
