ythuang96/FoamCutter/Solidworks Files/Electronics/PSU.SLDPRT

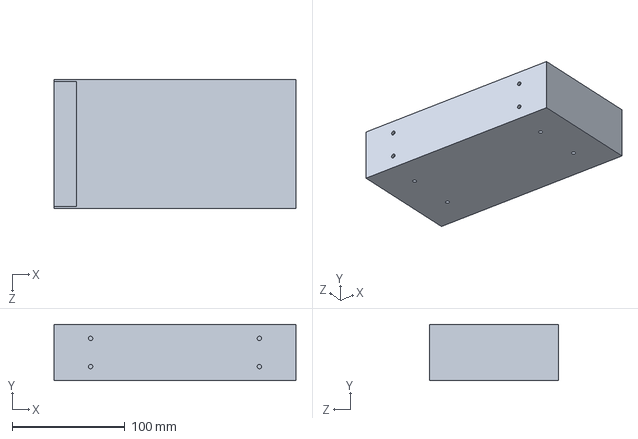
[picture p52: CAD file, 2018-08-23]
Solidworks Files/Electronics/PSU.SLDPRT
215.0 x 50.0 x 115.0 mm
