ythuang96/FoamCutter/Solidworks Files/Laser/Box/Back.DXF

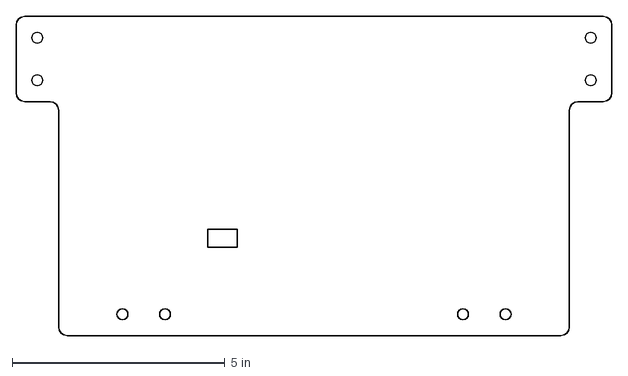
[picture p53: CAD file, 2018-08-23]
Solidworks Files/Laser/Box/Back.DXF
14.0 x 7.50 in
