ythuang96/FoamCutter/Solidworks Files/Laser/Spring Pulley Flange.DXF

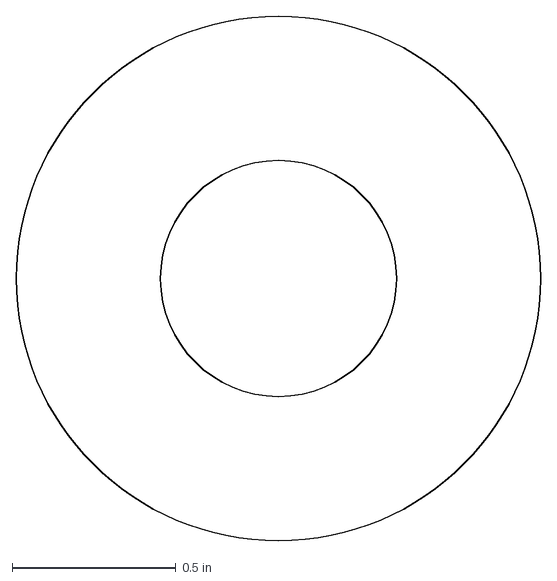
[picture p54: CAD file, 2018-08-23]
Solidworks Files/Laser/Spring Pulley Flange.DXF
1.60 x 1.60 in
