ythuang96/FoamCutter/Solidworks Files/T-Slot/4 ft.SLDPRT

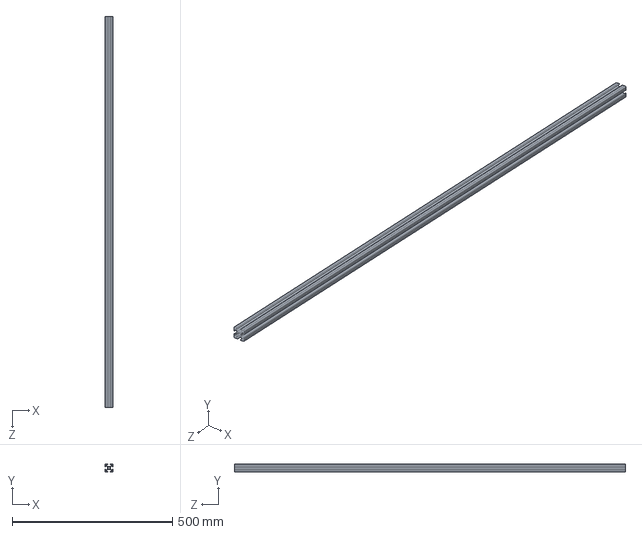
[picture p55: CAD file, 2018-08-23]
Solidworks Files/T-Slot/4 ft.SLDPRT
25.4 x 25.4 x 1219.2 mm
