ythuang96/FoamCutter/Solidworks Files/Wire Retraction/Al Pulley.SLDPRT

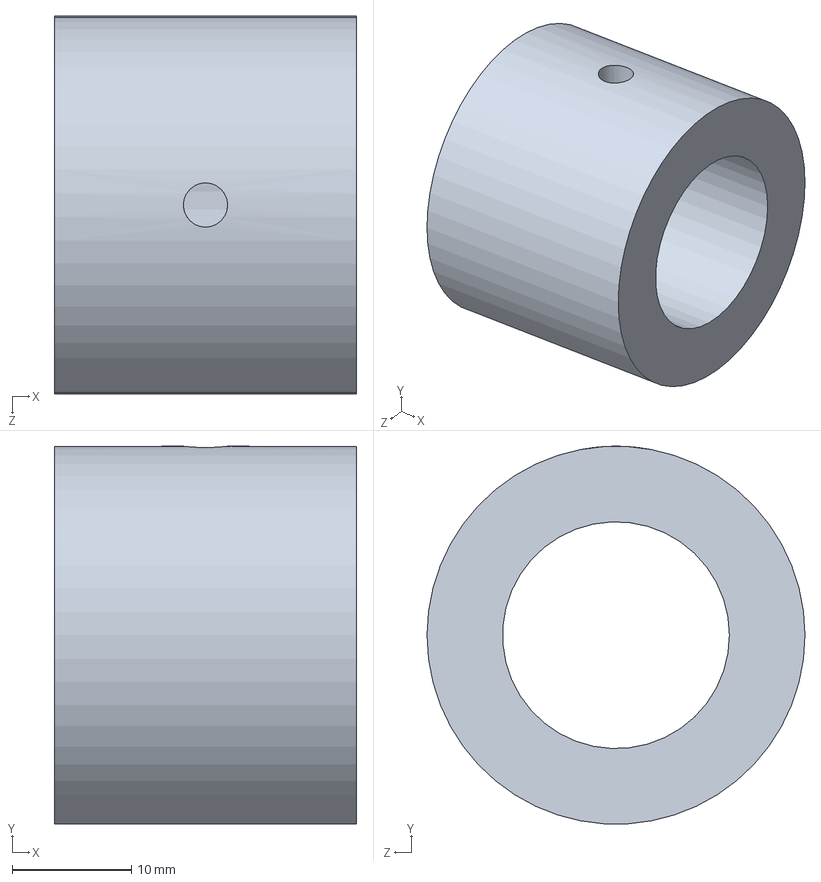
[picture p56: CAD file, 2018-08-23]
Solidworks Files/Wire Retraction/Al Pulley.SLDPRT
25.4 x 31.7 x 31.8 mm
