ythuang96/FoamCutter/Solidworks Files/Electronics/Limit Switch.SLDPRT

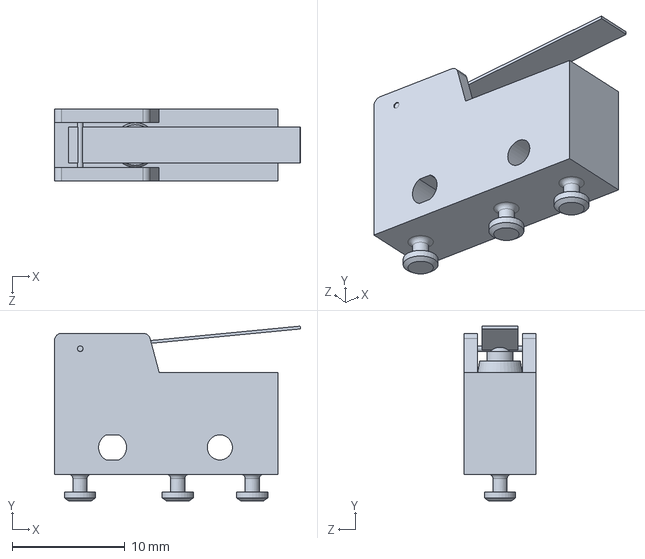
[picture p57: CAD file, 2018-08-23]
Solidworks Files/Electronics/Limit Switch.SLDPRT
21.8 x 15.5 x 6.35 mm
