ythuang96/FoamCutter/Solidworks Files/Laser/Box/Right.DXF

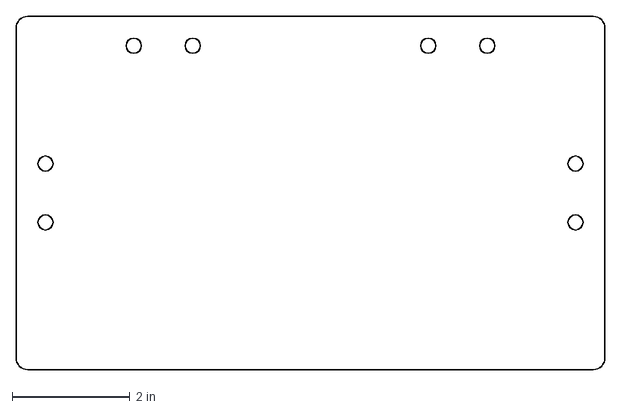
[picture p58: CAD file, 2018-08-23]
Solidworks Files/Laser/Box/Right.DXF
10.0 x 6.00 in
