ythuang96/FoamCutter/Solidworks Files/Laser/Mount Laser.dxf

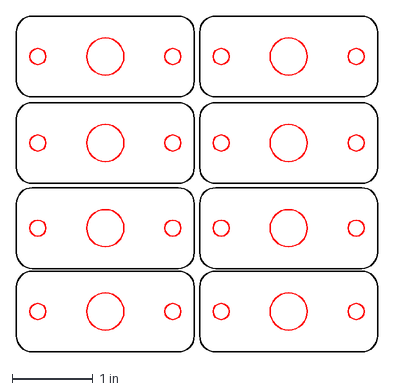
[picture p59: CAD file, 2018-08-23]
Solidworks Files/Laser/Mount Laser.dxf
4.47 x 4.15 in
