ythuang96/FoamCutter/Solidworks Files/T-Slot/3 ft.SLDPRT

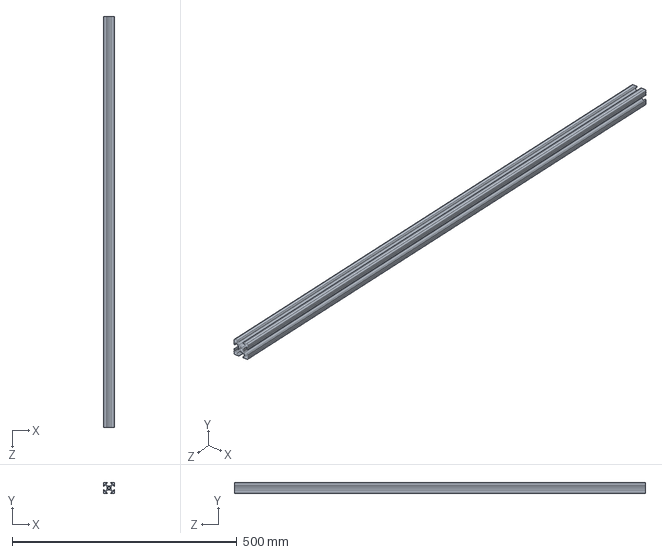
[picture p60: CAD file, 2018-08-23]
Solidworks Files/T-Slot/3 ft.SLDPRT
25.4 x 25.4 x 914.4 mm
