ythuang96/FoamCutter/Solidworks Files/Electronics/Switch.SLDPRT

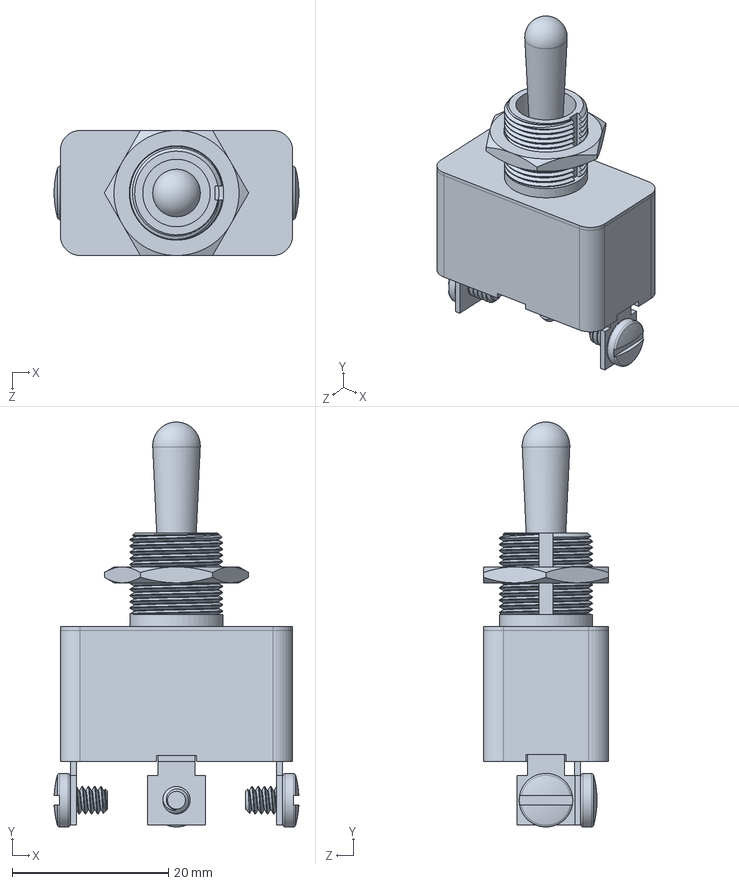
[picture p61: CAD file, 2018-08-23]
Solidworks Files/Electronics/Switch.SLDPRT
31.3 x 51.8 x 16.0 mm
