ythuang96/FoamCutter/Solidworks Files/Laser/Box/Front.DXF

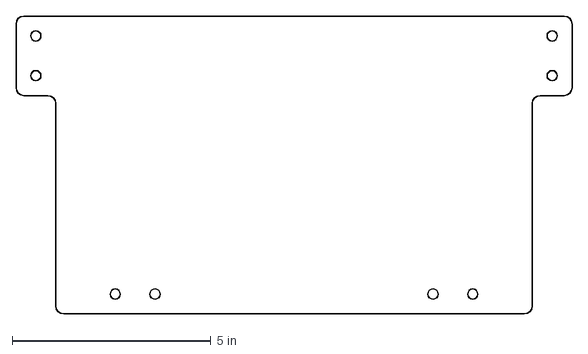
[picture p62: CAD file, 2018-08-23]
Solidworks Files/Laser/Box/Front.DXF
14.0 x 7.50 in
