ythuang96/FoamCutter/Solidworks Files/Laser/Shaft Flange.DXF

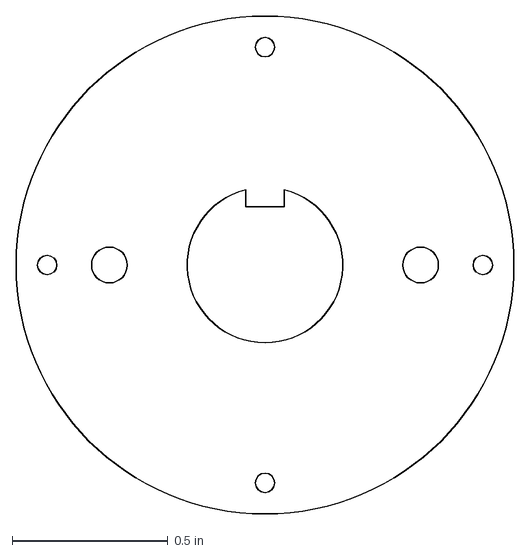
[picture p63: CAD file, 2018-08-23]
Solidworks Files/Laser/Shaft Flange.DXF
1.60 x 1.60 in
