ythuang96/FoamCutter/Solidworks Files/T-Slot/8 in.SLDPRT

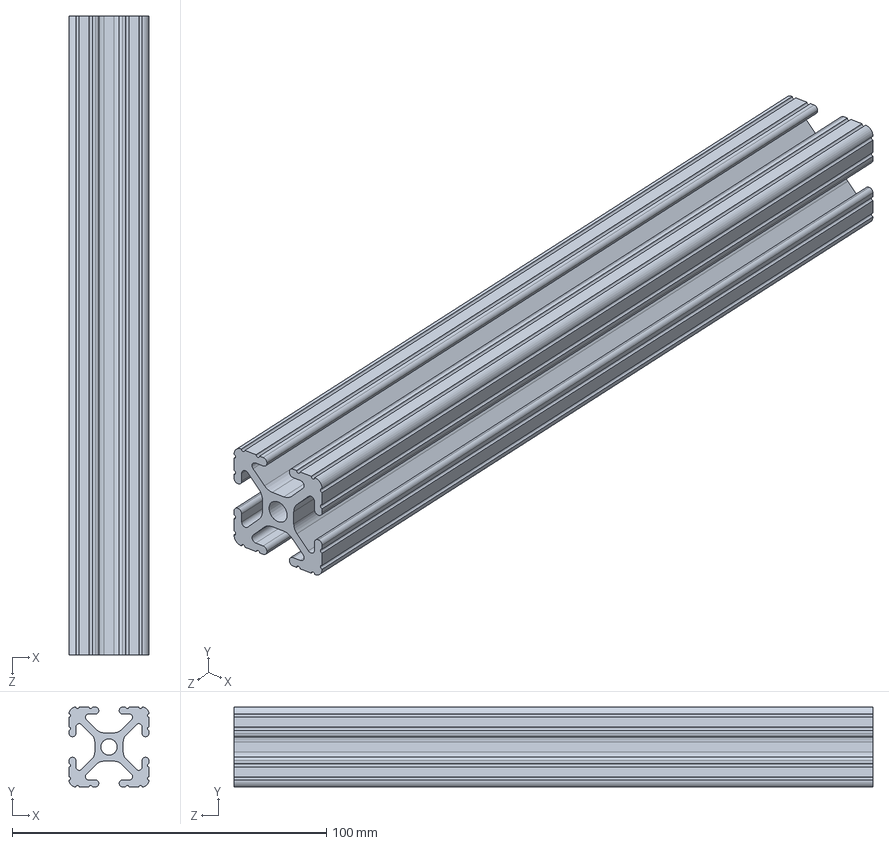
[picture p64: CAD file, 2018-08-23]
Solidworks Files/T-Slot/8 in.SLDPRT
25.4 x 25.4 x 203.2 mm
