ythuang96/FoamCutter/Solidworks Files/Wire Retraction/Flanged Sleeve Bearing 1.SLDPRT

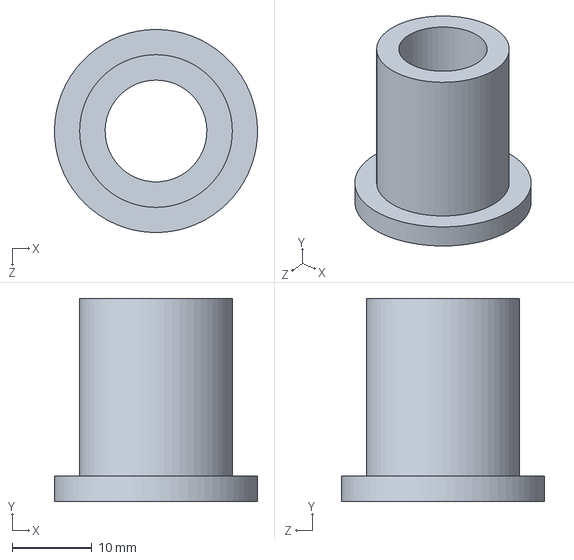
[picture p65: CAD file, 2018-08-23]
Solidworks Files/Wire Retraction/Flanged Sleeve Bearing 1.SLDPRT
25.4 x 25.4 x 25.4 mm
