ythuang96/FoamCutter/Solidworks Files/Al/Al sheet 4-2.SLDPRT

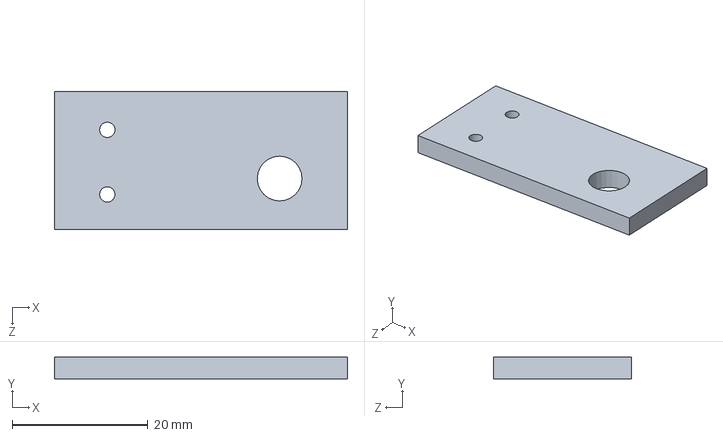
[picture p66: CAD file, 2018-08-23]
Solidworks Files/Al/Al sheet 4-2.SLDPRT
43.2 x 3.17 x 20.3 mm
