ythuang96/FoamCutter/Solidworks Files/Electronics/pi.SLDPRT

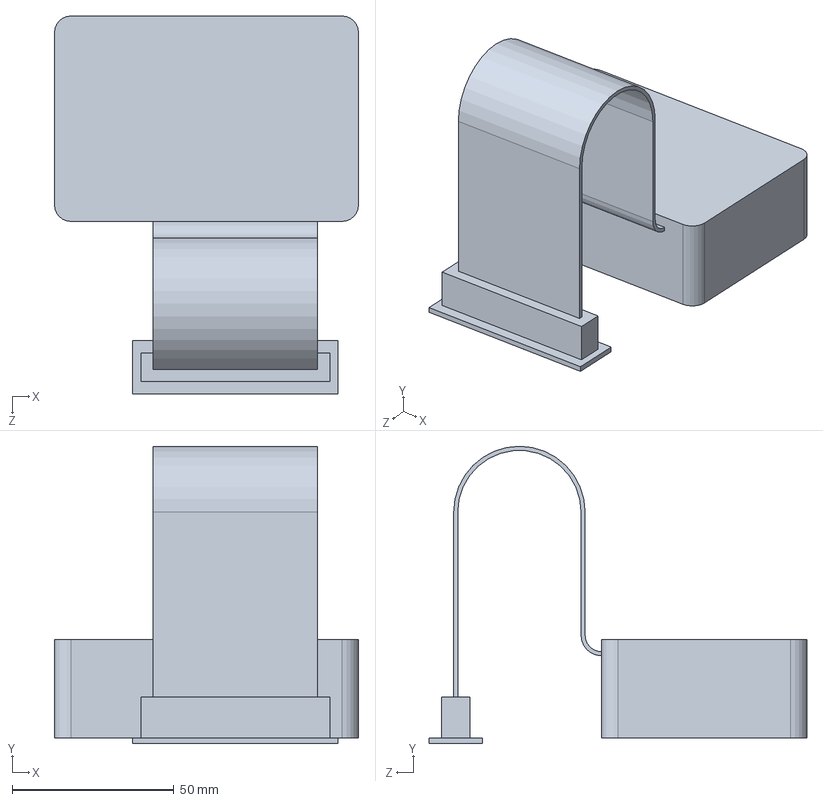
[picture p67: CAD file, 2018-08-23]
Solidworks Files/Electronics/pi.SLDPRT
94.0 x 91.9 x 116.8 mm
