ythuang96/FoamCutter/Solidworks Files/T-Slot/Corner Brace.SLDPRT

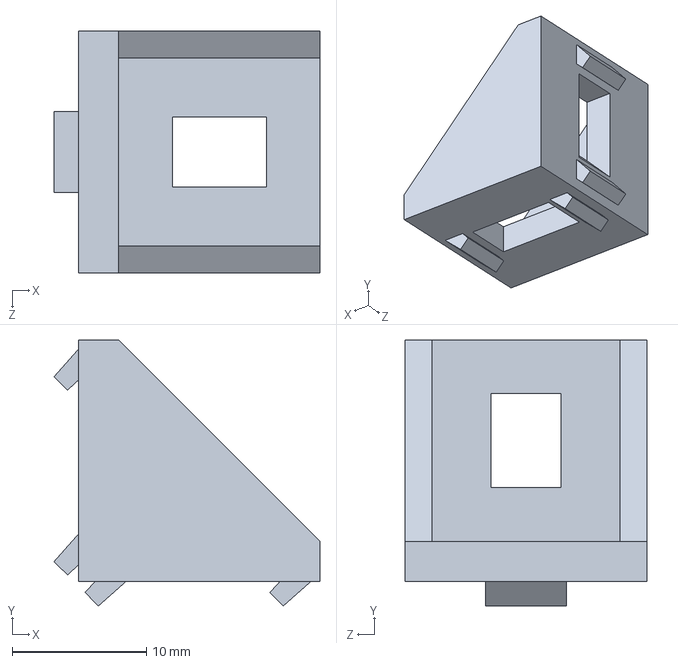
[picture p68: CAD file, 2018-08-23]
Solidworks Files/T-Slot/Corner Brace.SLDPRT
19.8 x 19.8 x 18.0 mm
