ythuang96/FoamCutter/Solidworks Files/Wire Retraction/Sleeve Bearing 1.5.SLDPRT

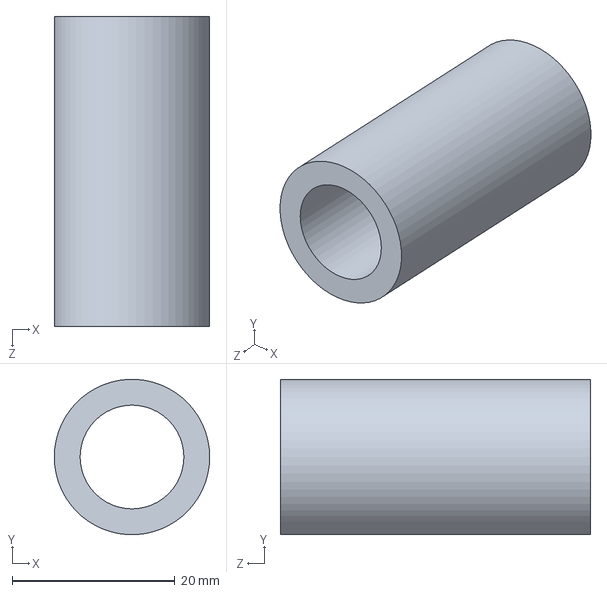
[picture p69: CAD file, 2018-08-23]
Solidworks Files/Wire Retraction/Sleeve Bearing 1.5.SLDPRT
19.1 x 19.1 x 38.1 mm
