ythuang96/FoamCutter/Solidworks Files/Al/Rectangle Tube.SLDPRT

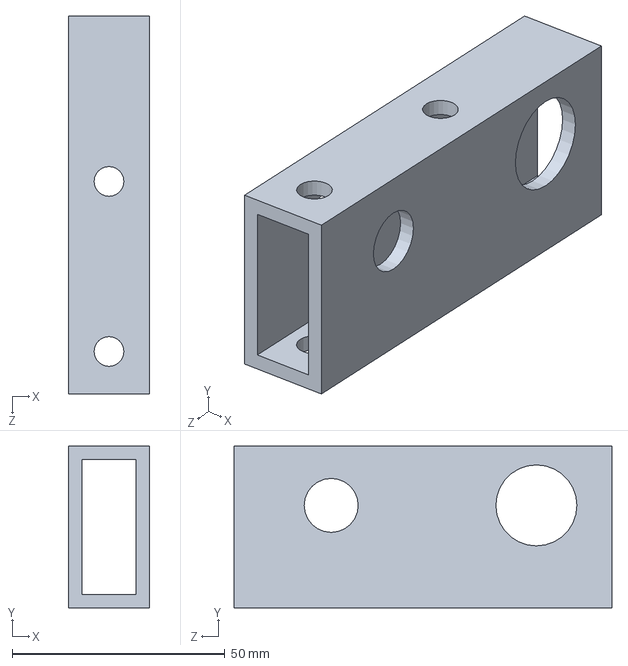
[picture p70: CAD file, 2018-08-23]
Solidworks Files/Al/Rectangle Tube.SLDPRT
19.1 x 38.1 x 88.9 mm
