ythuang96/FoamCutter/Solidworks Files/Electronics/Motor Mount.SLDPRT

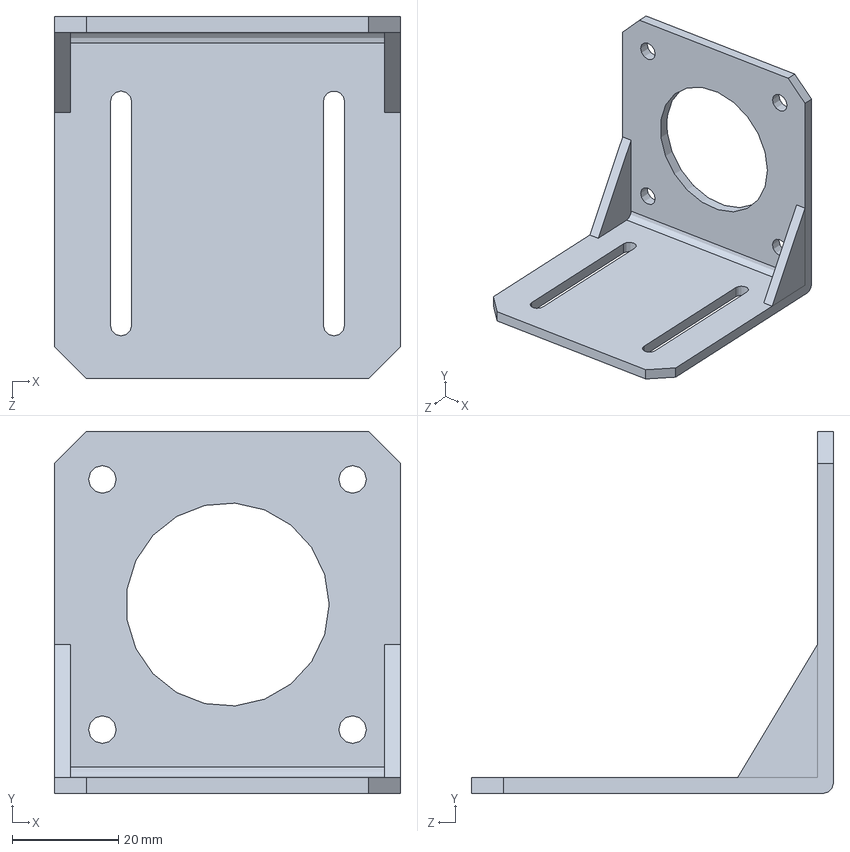
[picture p71: CAD file, 2018-08-23]
Solidworks Files/Electronics/Motor Mount.SLDPRT
65.0 x 68.0 x 68.0 mm
