ythuang96/FoamCutter/Solidworks Files/T-Slot/Outside Corner.SLDPRT

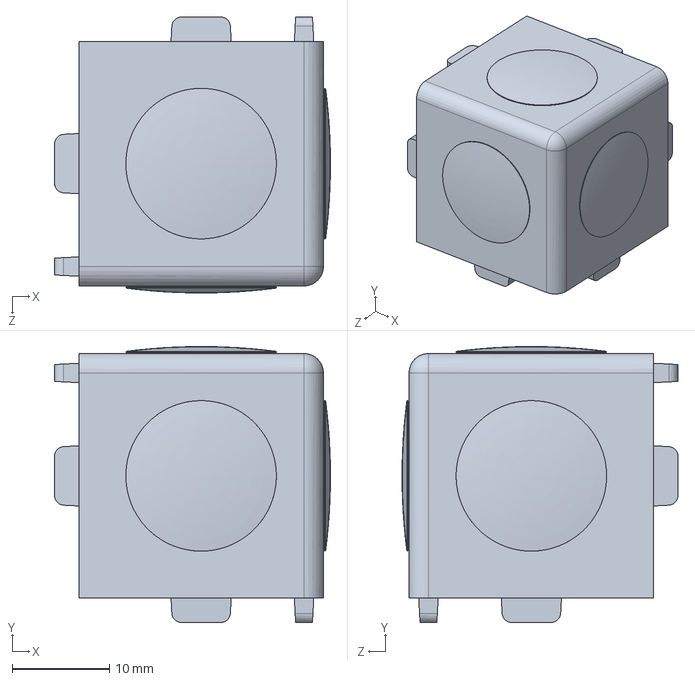
[picture p72: CAD file, 2018-08-23]
Solidworks Files/T-Slot/Outside Corner.SLDPRT
28.4 x 28.4 x 28.4 mm
