ythuang96/FoamCutter/Solidworks Files/Wire Retraction/Constant Force Spring.SLDPRT

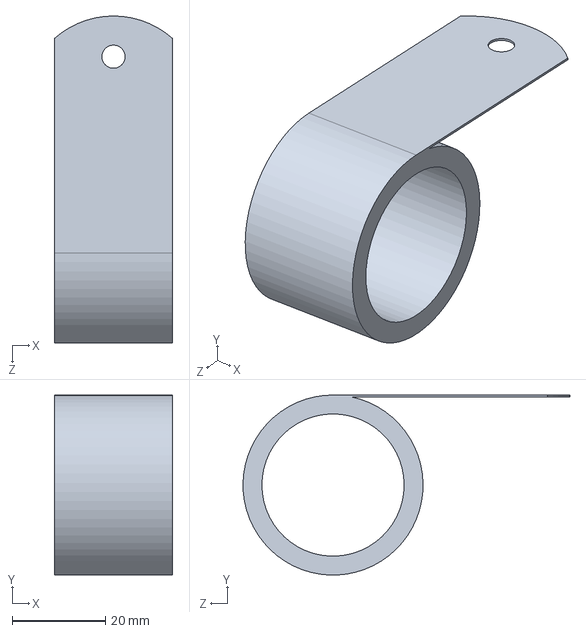
[picture p73: CAD file, 2018-08-23]
Solidworks Files/Wire Retraction/Constant Force Spring.SLDPRT
25.4 x 38.6 x 70.1 mm
