ythuang96/FoamCutter/Solidworks Files/Al/Al sheet 4-1.SLDPRT

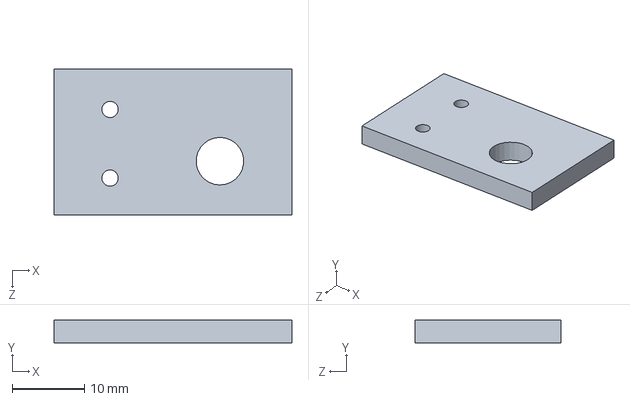
[picture p74: CAD file, 2018-08-23]
Solidworks Files/Al/Al sheet 4-1.SLDPRT
33.0 x 3.17 x 20.3 mm
