ythuang96/FoamCutter/Solidworks Files/Electronics/Nema 23 Stepper Motor.SLDPRT

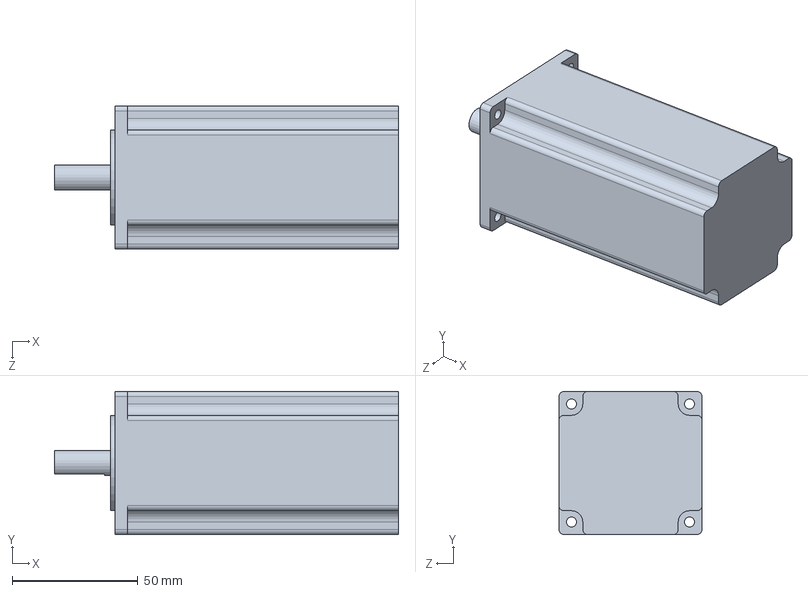
[picture p75: CAD file, 2018-08-23]
Solidworks Files/Electronics/Nema 23 Stepper Motor.SLDPRT
137.0 x 57.0 x 57.0 mm
