ythuang96/FoamCutter/Solidworks Files/T-Slot/3 in.SLDPRT

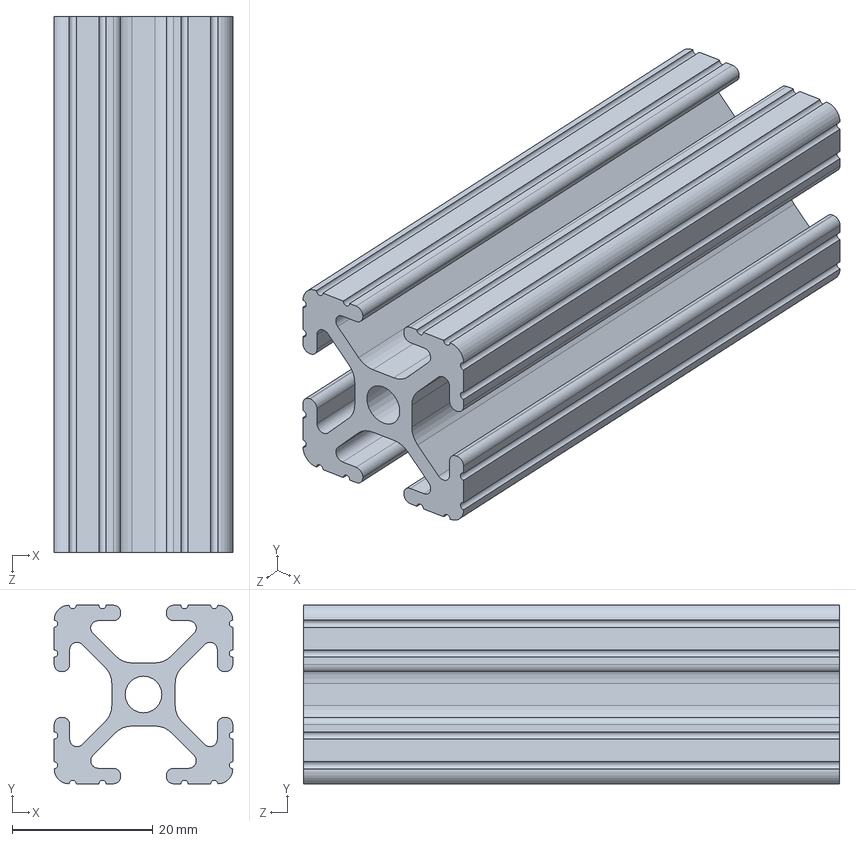
[picture p76: CAD file, 2018-08-23]
Solidworks Files/T-Slot/3 in.SLDPRT
25.4 x 25.4 x 76.2 mm
