ythuang96/FoamCutter/Solidworks Files/Wire Retraction/Sleeve Bearing Wire.SLDPRT

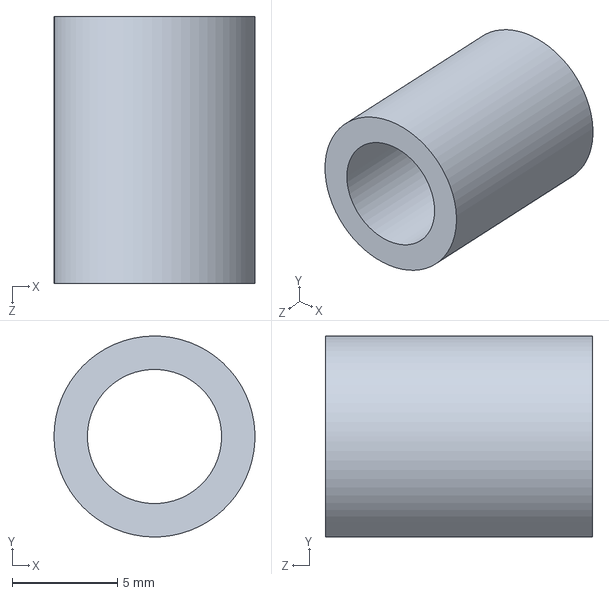
[picture p77: CAD file, 2018-08-23]
Solidworks Files/Wire Retraction/Sleeve Bearing Wire.SLDPRT
9.55 x 9.55 x 12.7 mm
