ythuang96/FoamCutter/Solidworks Files/T-Slot/2 ft.SLDPRT

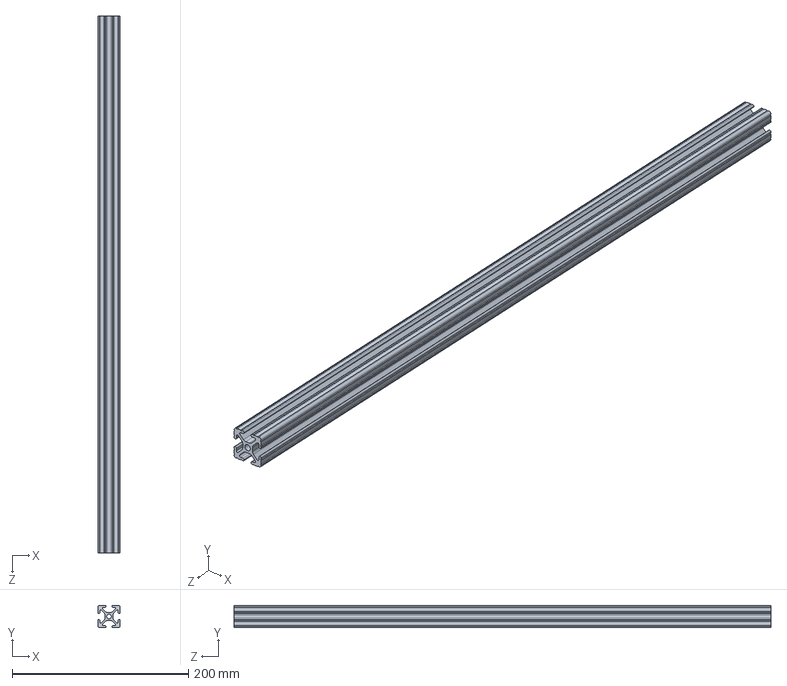
[picture p78: CAD file, 2018-08-23]
Solidworks Files/T-Slot/2 ft.SLDPRT
25.4 x 25.4 x 609.6 mm
