ythuang96/FoamCutter/Solidworks Files/T-Slot/1 ft.SLDPRT

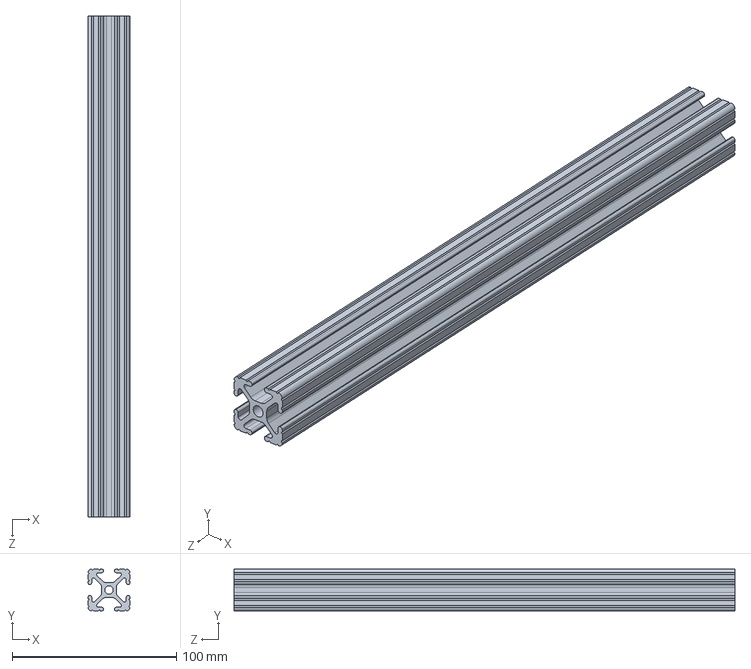
[picture p79: CAD file, 2018-08-23]
Solidworks Files/T-Slot/1 ft.SLDPRT
25.4 x 25.4 x 304.8 mm
