ythuang96/FoamCutter/Solidworks Files/Wire Retraction/Shaft Collar.SLDPRT

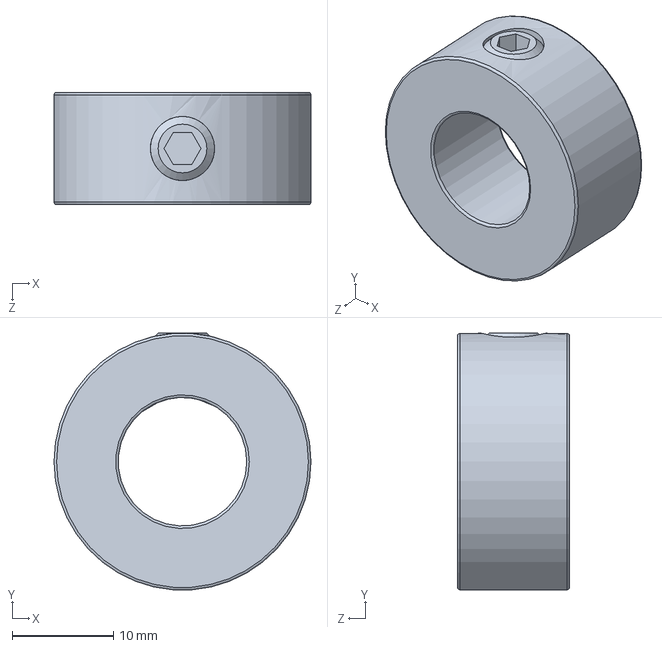
[picture p80: CAD file, 2018-08-23]
Solidworks Files/Wire Retraction/Shaft Collar.SLDPRT
25.4 x 25.4 x 11.1 mm
