ythuang96/FoamCutter/Solidworks Files/T-Slot/34in.SLDPRT

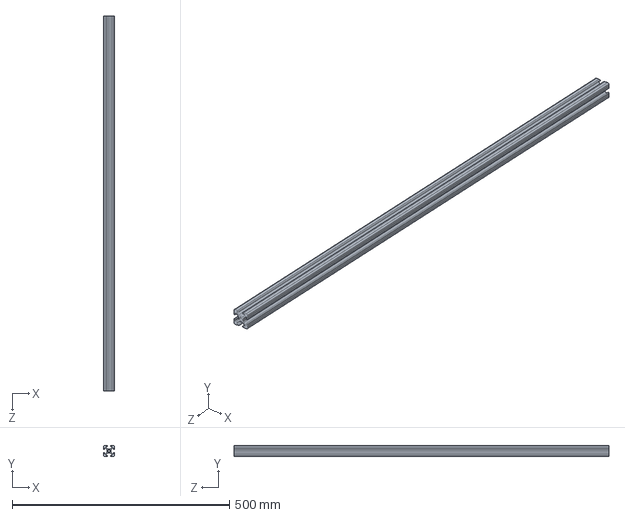
[picture p81: CAD file, 2018-08-23]
Solidworks Files/T-Slot/34in.SLDPRT
25.4 x 25.4 x 863.6 mm
