ythuang96/FoamCutter/Solidworks Files/Wire Retraction/One-Way Bearing.SLDPRT

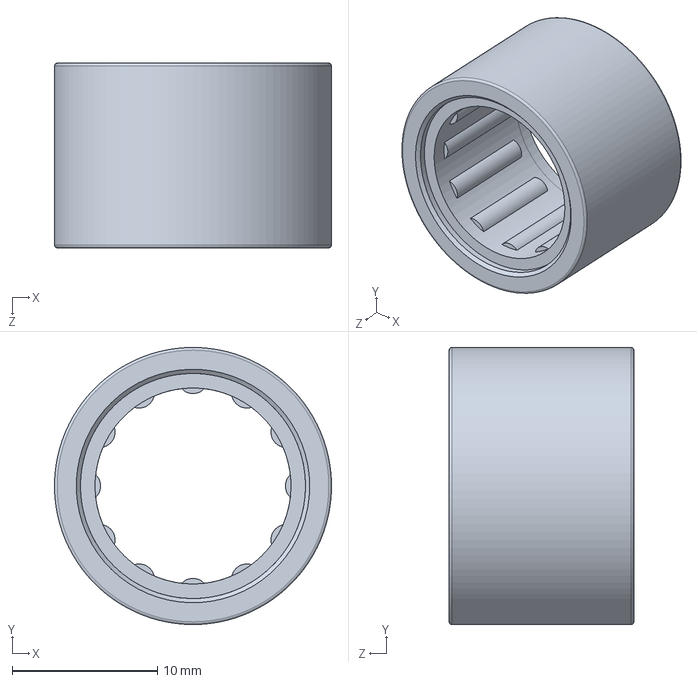
[picture p82: CAD file, 2018-08-23]
Solidworks Files/Wire Retraction/One-Way Bearing.SLDPRT
19.0 x 19.1 x 12.7 mm
