ythuang96/FoamCutter/(list of files, cad)

Other CAD files:
Solidworks Files/Assembly/Limit Swtich Assembly 1.SLDASM
Solidworks Files/Laser/Box Laser.dwg
Solidworks Files/Al/Al sheet 1.SLDPRT
Solidworks Files/Al/Al sheet 3-2.SLDPRT
Solidworks Files/T-Slot/Corner Surface.SLDPRT
Solidworks Files/Al/L Bracket -- Nut Horizontal.SLDPRT
Solidworks Files/Al/L Bracket -- Nut Vertical.SLDPRT
Solidworks Files/Drawings/1.SLDDRW
Solidworks Files/Laser/Guiding Block/Block Laser.dwg
Solidworks Files/Laser/Mount Laser.dwg
Solidworks Files/Lead Screw Parts/Acrylic Bearing Mount.SLDPRT
Solidworks Files/Lead Screw Parts/Collar.SLDPRT
Solidworks Files/Lead Screw Parts/Lead Screw 2.5ft.SLDPRT
Solidworks Files/Lead Screw Parts/Lead Screw 3ft.SLDPRT
Solidworks Files/Lead Screw Parts/Lead Screw Sample.SLDPRT
Solidworks Files/Lead Screw Parts/Nut.SLDPRT
Solidworks Files/Lead Screw Parts/Shaft Coupler.SLDPRT
Solidworks Files/Lead Screw Parts/Shim.SLDPRT
Solidworks Files/Screws/#4-0.5.SLDPRT
Solidworks Files/Screws/0.25 Nut.SLDPRT
Solidworks Files/Screws/0.25-0.5.SLDPRT
Solidworks Files/Screws/0.25-1.SLDPRT
Solidworks Files/Screws/0.5 Nut.SLDPRT
Solidworks Files/Screws/0.5-3.5.SLDPRT
Solidworks Files/Screws/M6 Nut.SLDPRT
Solidworks Files/Screws/M6-12.SLDPRT
Solidworks Files/Screws/M6-20.SLDPRT
Solidworks Files/Screws/M6-30.SLDPRT
