ythuang96/FoamCutter/Solidworks Files/Drawings/1.PDF

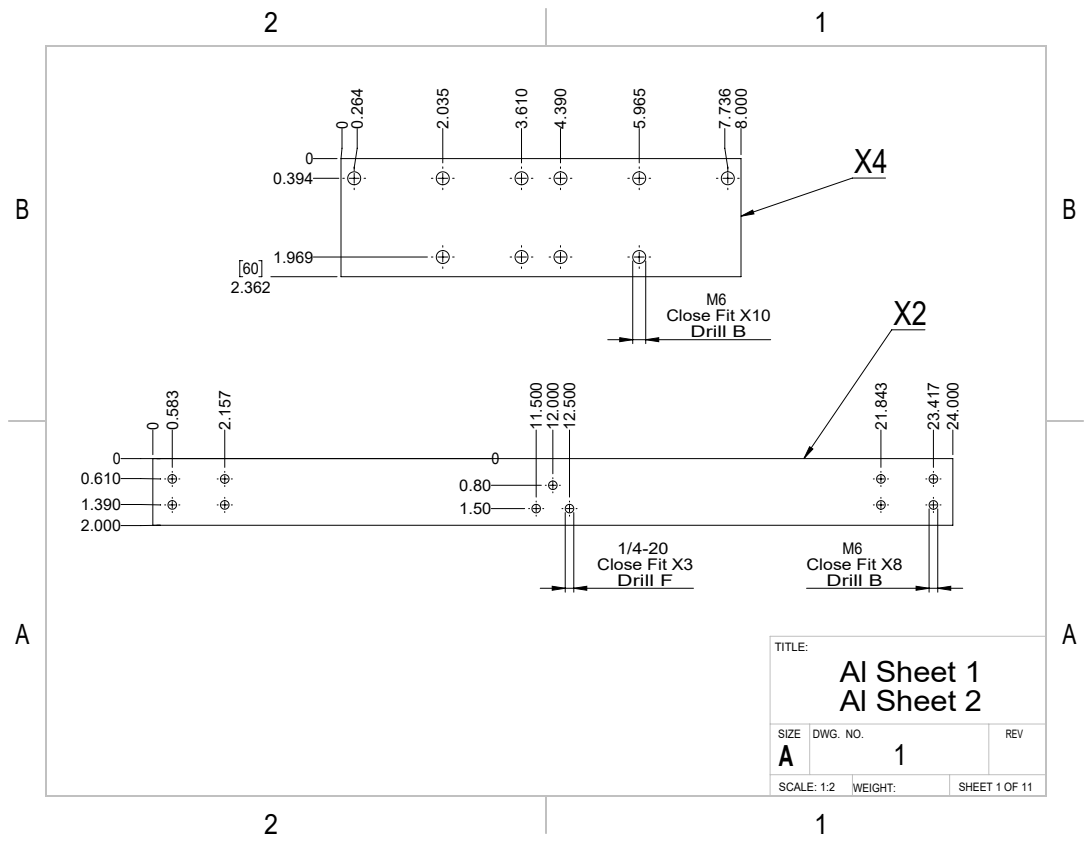
[picture p137: page 1]
Close Fit X10 Drill B; Close Fit X3 Drill F; Close Fit X8 Drill B; Al Sheet 1 Al Sheet 2

SIZE A | DWG. NO. 1 | REV

SCALE: 1:2 | WEIGHT: | SHEET 1 OF 11

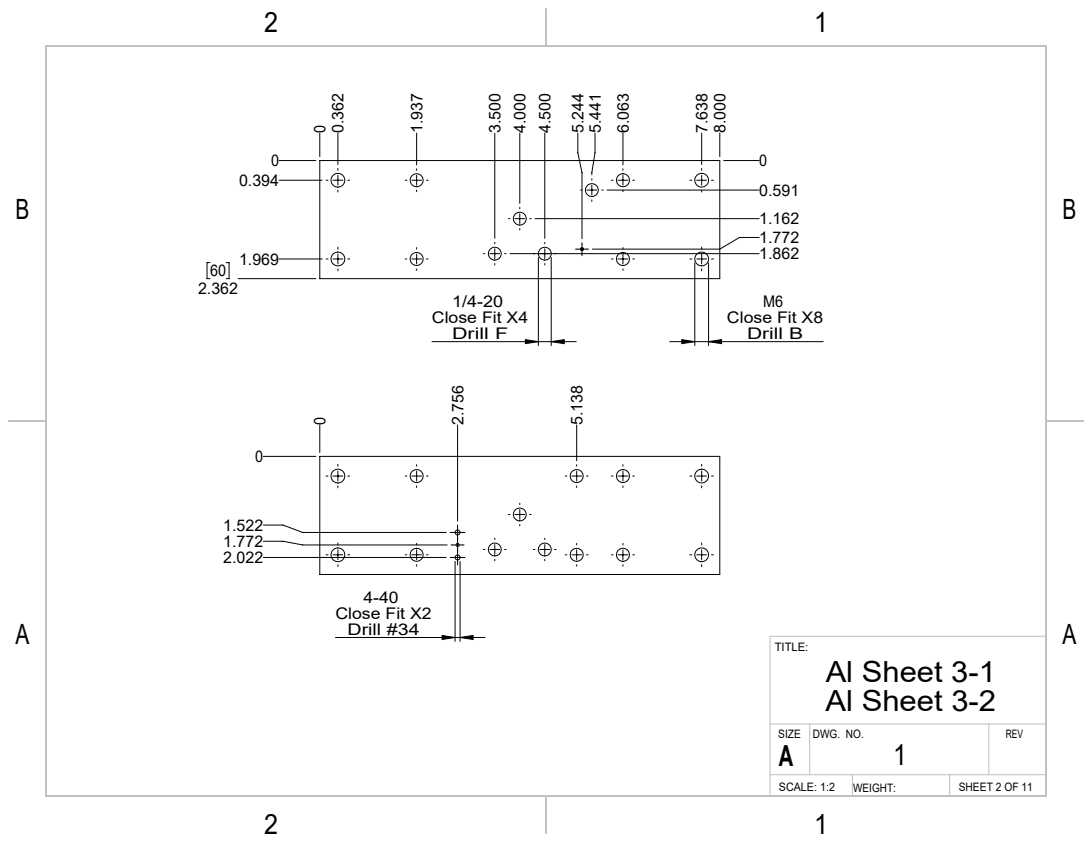
[picture p138: page 2]
Close Fit X4 Drill F; Close Fit X8 Drill B; Close Fit X2 Drill #34; Al Sheet 3-1 Al Sheet 3-2

SIZE A | DWG. NO. 1 | REV

SCALE: 1:2 | WEIGHT: | SHEET 2 OF 11

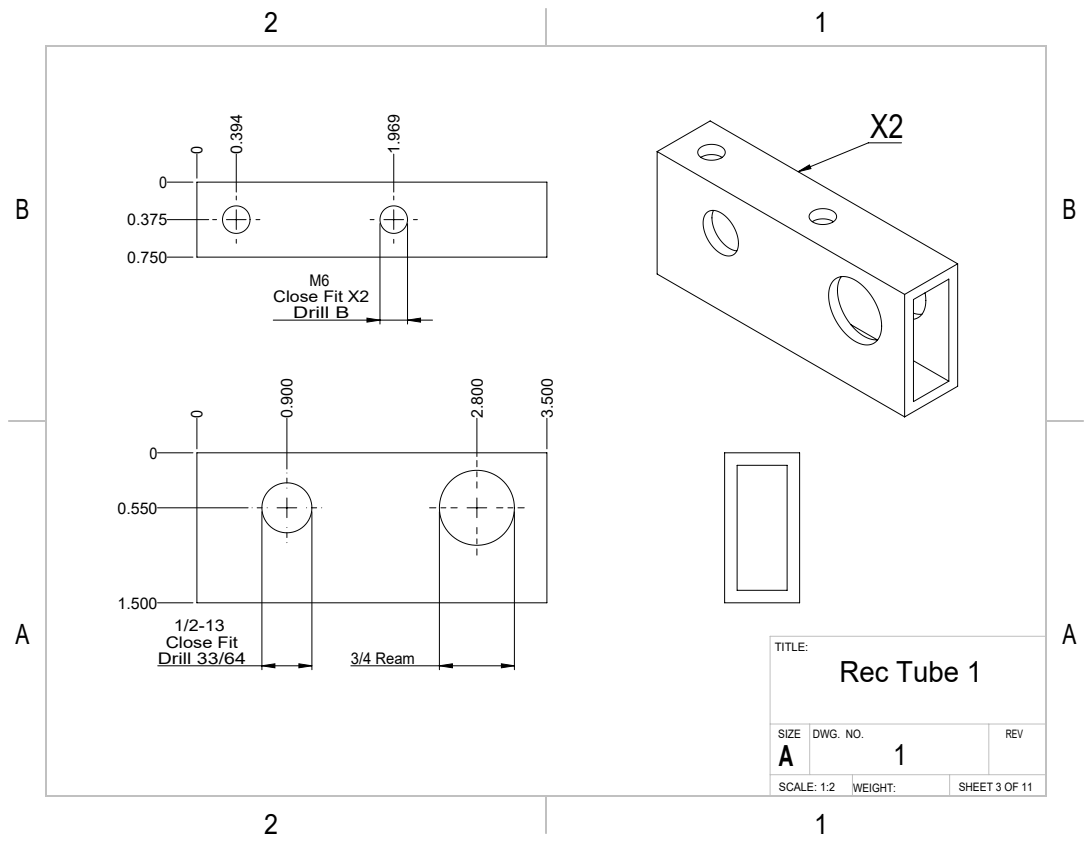
[picture p139: page 3]
Close Fit; Drill 33/64; 3/4 Ream; Close Fit X2 Drill B; Rec Tube 1

SIZE A | DWG. NO. 1 | REV

SCALE: 1:2 | WEIGHT: | SHEET 3 OF 11

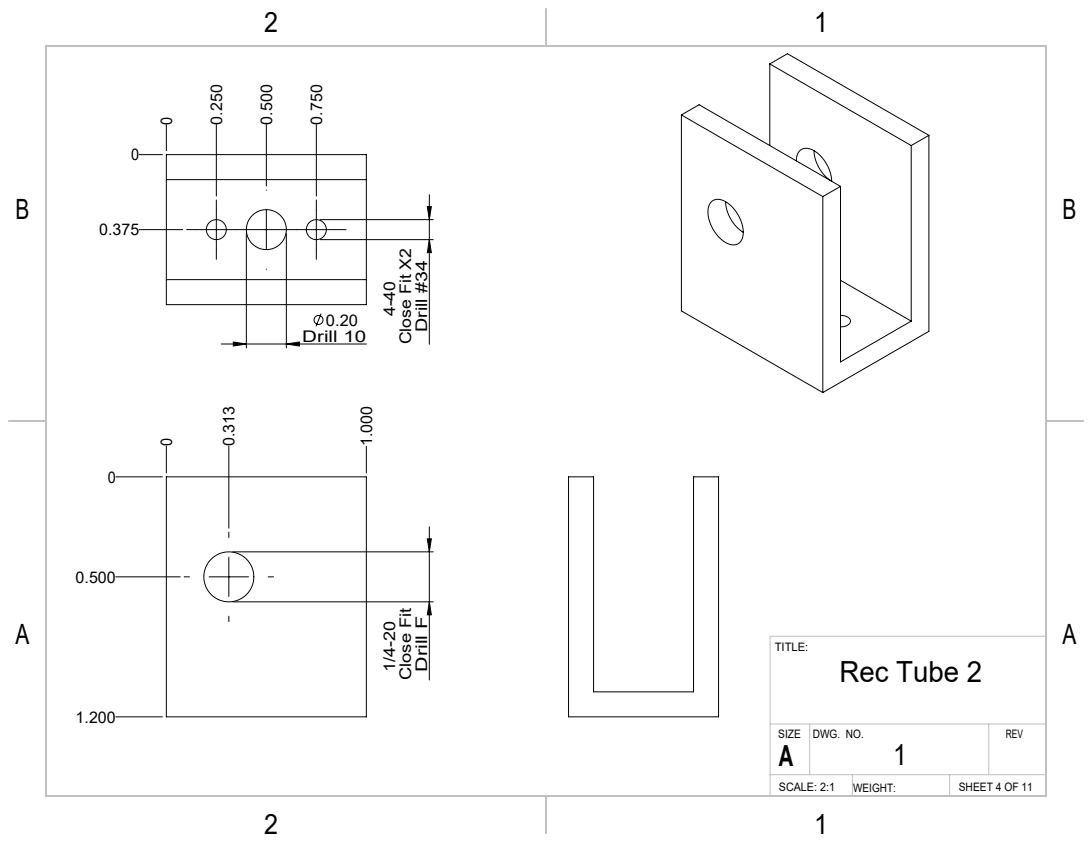
[picture p140: page 4]
Close Fit Drill F; Close Fit X2 Drill #34; Drill 10; Rec Tube 2 1

SIZE A | DWG. NO. | REV

SCALE: 2:1 | WEIGHT: | SHEET 4 OF 11

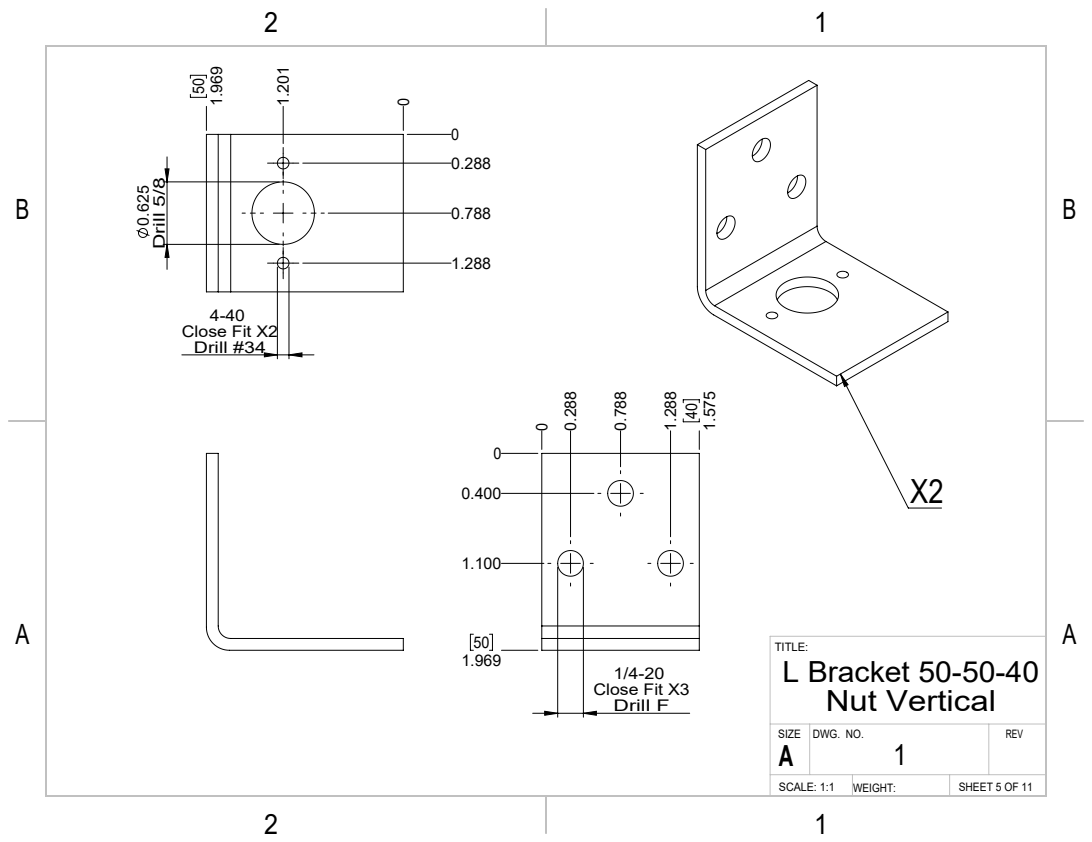
[picture p141: page 5]
Close Fit X3 Drill F; Drill 5/8; Close Fit X2 Drill #34; L Bracket 50-50-40 Nut Vertical

SIZE A | DWG. NO. 1 | REV

SCALE: 1:1 | WEIGHT: | SHEET 5 OF 11

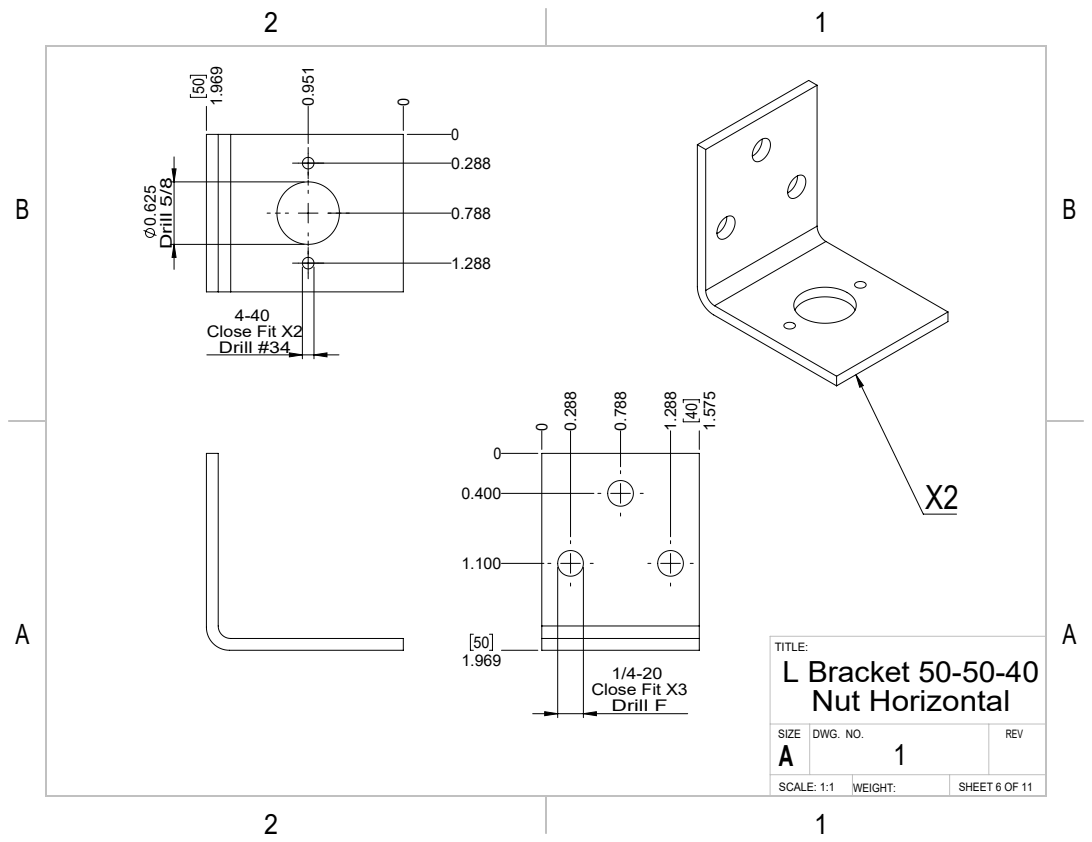
[picture p142: page 6]
Close Fit X3 Drill F; Drill 5/8; Close Fit X2 Drill #34; L Bracket 50-50-40 Nut Horizontal; DWG. NO.; REV

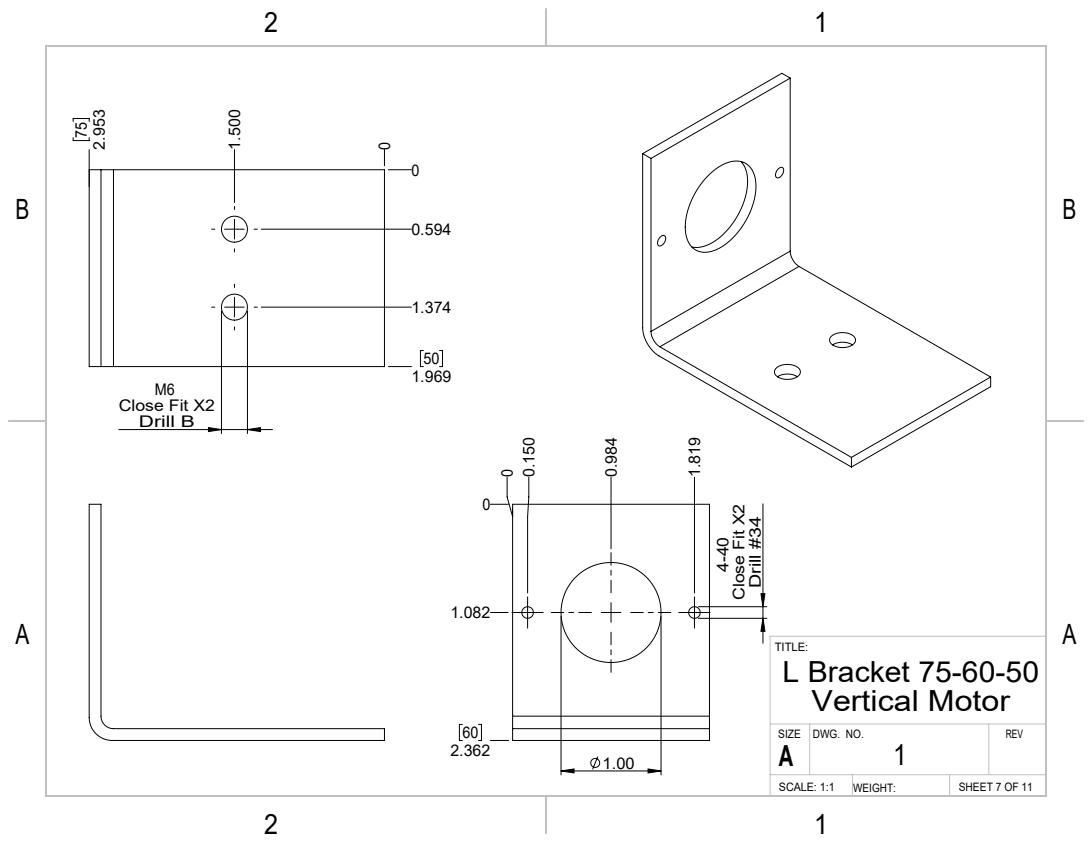
[picture p143: page 7]
Close Fit X2 Drill B; Close Fit X2 Drill #34; L Bracket 75-60-50 Vertical Motor; DWG. NO.; REV

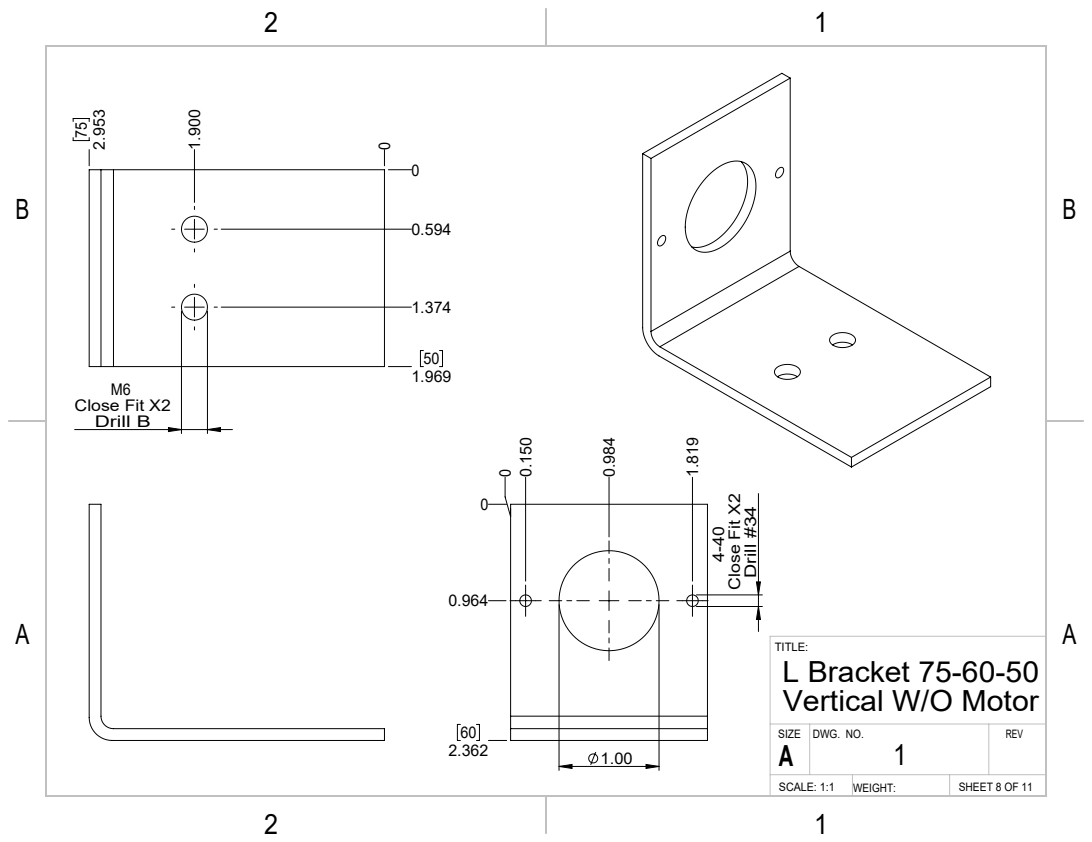
[picture p144: page 8]
Close Fit X2 Drill B; Close Fit X2 Drill #34; L Bracket 75-60-50 Vertical W/O Motor; DWG. NO.; REV

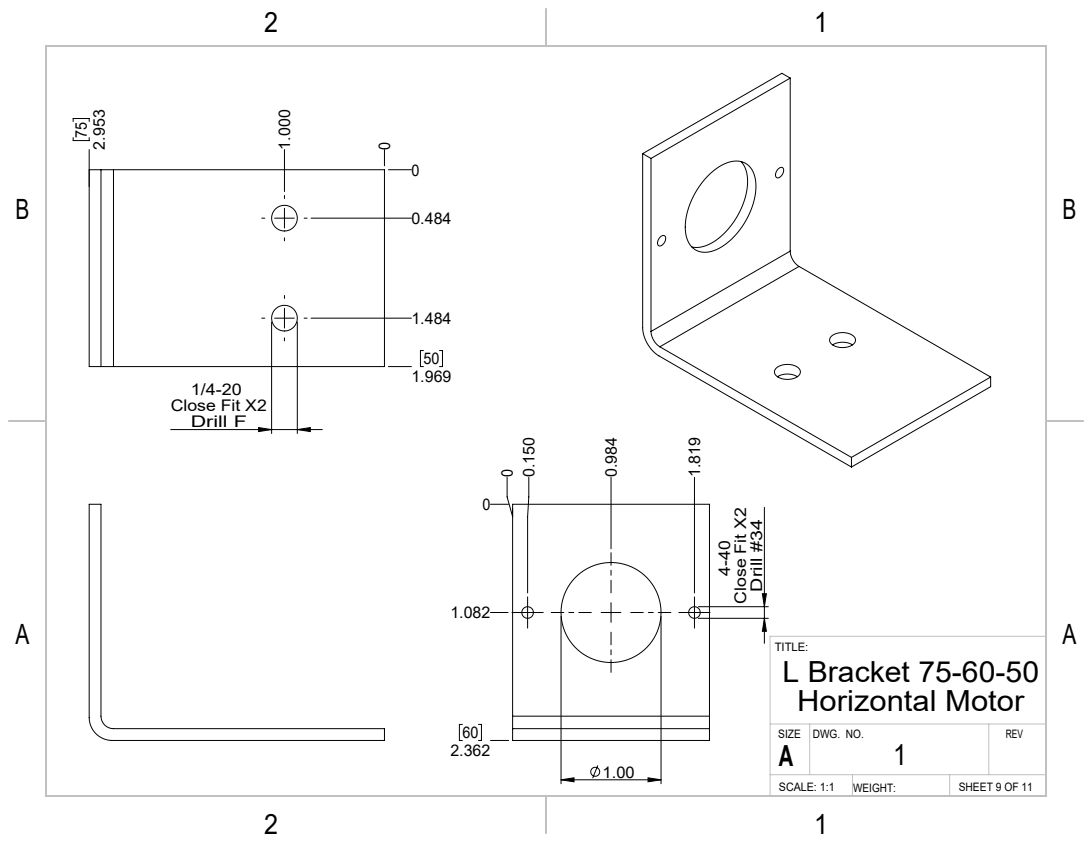
[picture p145: page 9]
Close Fit X2 Drill F; Close Fit X2 Drill #34; L Bracket 75-60-50 Horizontal Motor; DWG. NO.; REV

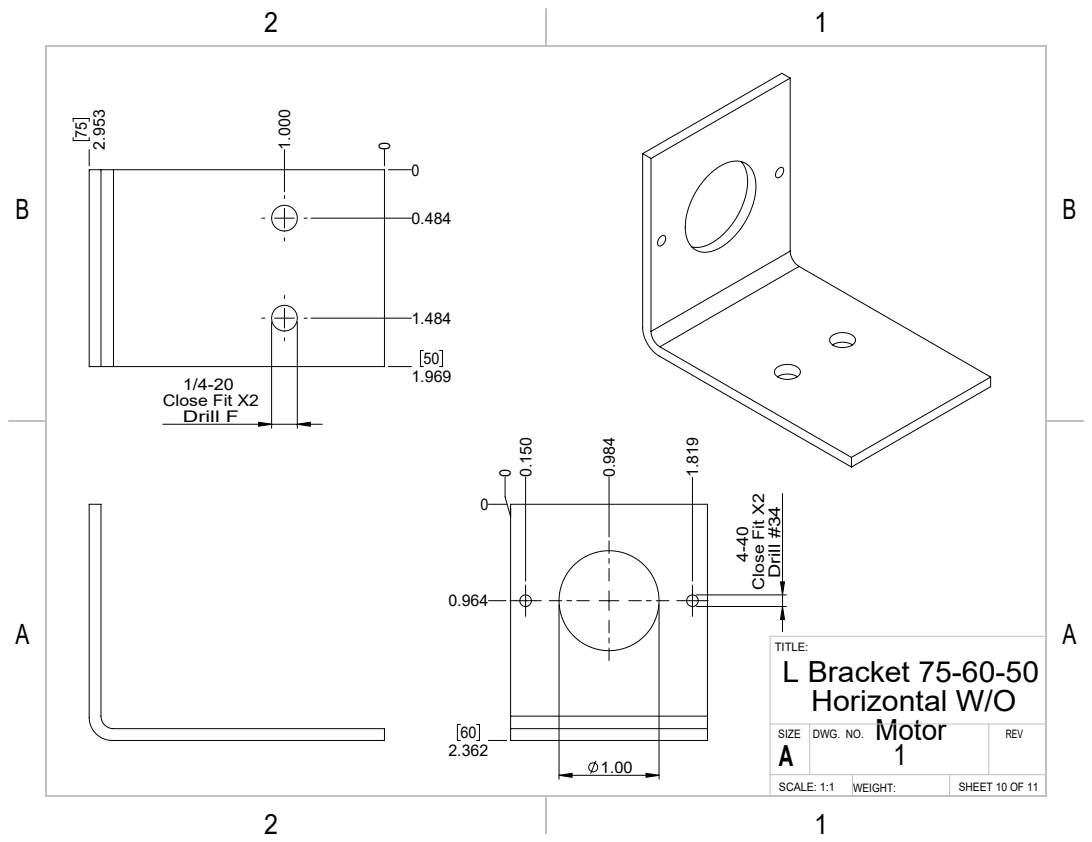
[picture p146: page 10]
Close Fit X2 Drill F; Close Fit X2 Drill #34; L Bracket 75-60-50 Horizontal W/O; DWG. NO.; REV

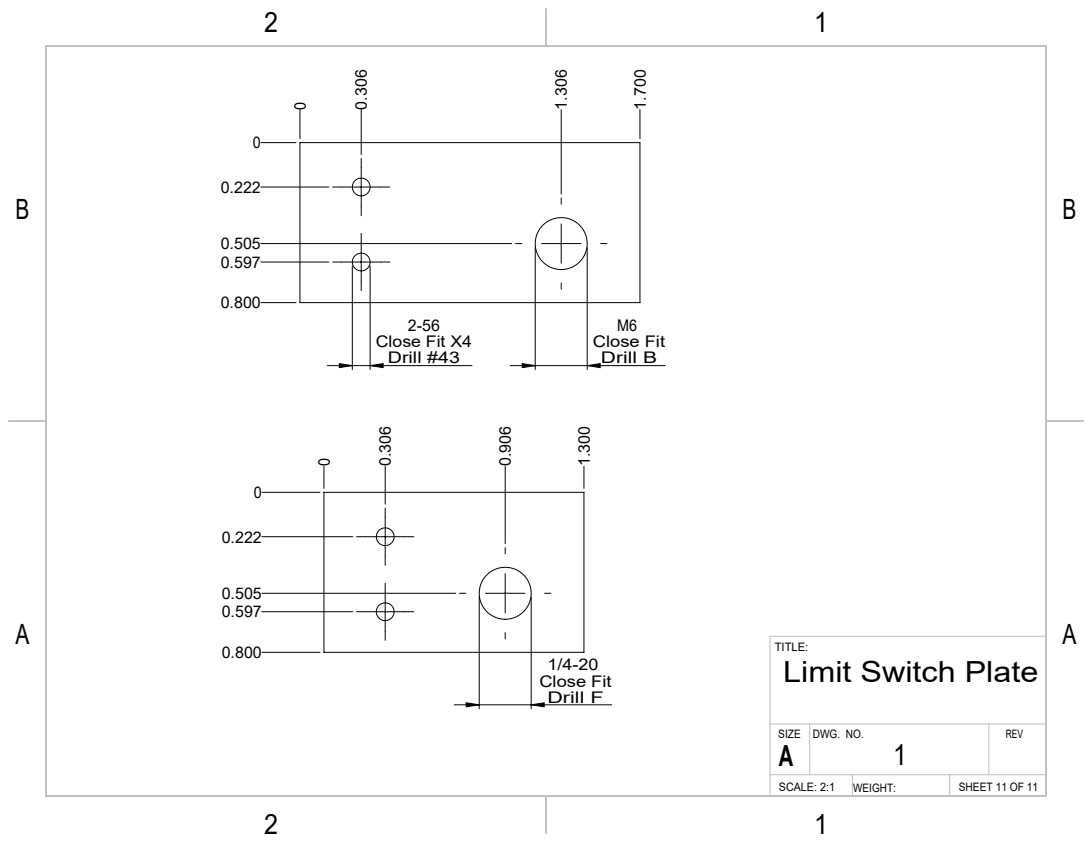
[picture p147: page 11]
Close Fit Drill B; Close Fit X4 Drill #43; Close Fit Drill F

TITLE:
Limit Switch Plate

SIZE A | DWG. NO. 1 | REV

SCALE: 2:1 | WEIGHT: | SHEET 11 OF 11
