ythuang96/FoamCutter/(commit log)

2018-08-30 Manual Update
    [Part List.xlsx]
2019-01-14 MatLab Wing code bug fix
